ferraritobias/proteus/hardware/proteus-br/reports/contract-validation.txt

== 1. MCU (U1501) x PINOUT-CONTRACT ==
OK   U1501 BOOT0 (pad 138)        /mcu/BOOT0 (esperado substr:BOOT0)
OK   U1501 NRST (pad 25)          /mcu/nRESET (esperado substr:nRESET)
OK   U1501 PA0 (pad 34)           AV5_F (esperado AV5_F)
OK   U1501 PA1 (pad 35)           AV6_F (esperado AV6_F)
OK   U1501 PA11 (pad 103)         /mcu/USB_D- (esperado substr:USB_D-)
OK   U1501 PA12 (pad 104)         /mcu/USB_D+ (esperado substr:USB_D+)
OK   U1501 PA13 (pad 105)         /mcu/SWDIO (esperado substr:SWDIO)
OK   U1501 PA14 (pad 109)         /mcu/SWCLK (esperado substr:SWCLK)
OK   U1501 PA2 (pad 36)           AV7_F (esperado AV7_F)
OK   U1501 PA3 (pad 37)           AV8_F (esperado AV8_F)
OK   U1501 PA4 (pad 40)           AV9_F (esperado AV9_F)
OK   U1501 PA5 (pad 41)           AV10_F (esperado AV10_F)
OK   U1501 PA6 (pad 42)           AV11_F (esperado AV11_F)
OK   U1501 PA7 (pad 43)           /mcu/12V_DIVIDED (esperado substr:12V_DIVIDED)
OK   U1501 PA8 (pad 100)          HS2_IN (esperado HS2_IN)
OK   U1501 PA9 (pad 101)          HS1_IN (esperado HS1_IN)
OK   U1501 PB0 (pad 46)           AT3_F (esperado AT3_F)
OK   U1501 PB1 (pad 47)           AT4_F (esperado AT4_F)
OK   U1501 PB12 (pad 73)          CAN2_RX (esperado CAN2_RX)
OK   U1501 PB13 (pad 74)          CAN2_TX (esperado CAN2_TX)
OK   U1501 PB2 (pad 48)           GND (esperado GND)
OK   U1501 PB4 (pad 134)          LS8_IN (esperado LS8_IN)
OK   U1501 PB5 (pad 135)          LS9_IN (esperado LS9_IN)
OK   U1501 PB6 (pad 136)          LS10_IN (esperado LS10_IN)
OK   U1501 PB7 (pad 137)          LS11_IN (esperado LS11_IN)
OK   U1501 PB8 (pad 139)          LS12_IN (esperado LS12_IN)
OK   U1501 PB9 (pad 140)          LS13_IN (esperado LS13_IN)
OK   U1501 PC0 (pad 26)           AV1_F (esperado AV1_F)
OK   U1501 PC1 (pad 27)           AV2_F (esperado AV2_F)
OK   U1501 PC10 (pad 111)         /mcu/SD_SCK (esperado substr:SD_SCK)
OK   U1501 PC11 (pad 112)         /mcu/SD_MISO (esperado substr:SD_MISO)
OK   U1501 PC12 (pad 113)         /mcu/SD_MOSI (esperado substr:SD_MOSI)
OK   U1501 PC14 (pad 8)           5V_SENSOR_2_PG (esperado 5V_SENSOR_2_PG)
OK   U1501 PC15 (pad 9)           5V_SENSOR_1_PG (esperado 5V_SENSOR_1_PG)
OK   U1501 PC2 (pad 28)           AV3_F (esperado AV3_F)
OK   U1501 PC3 (pad 29)           AV4_F (esperado AV4_F)
OK   U1501 PC4 (pad 44)           AT1_F (esperado AT1_F)
OK   U1501 PC5 (pad 45)           AT2_F (esperado AT2_F)
OK   U1501 PC6 (pad 96)           HALL_OUT_1 (esperado HALL_OUT_1)
OK   U1501 PC7 (pad 97)           IGN5_IN (esperado IGN5_IN)
OK   U1501 PC8 (pad 98)           IGN4_IN (esperado IGN4_IN)
OK   U1501 PC9 (pad 99)           IGN3_IN (esperado IGN3_IN)
OK   U1501 PD0 (pad 114)          CAN1_RX (esperado CAN1_RX)
OK   U1501 PD1 (pad 115)          CAN1_TX (esperado CAN1_TX)
OK   U1501 PD10 (pad 79)          ETB1_DIR (esperado ETB1_DIR)
OK   U1501 PD11 (pad 80)          ETB1_DIS (esperado ETB1_DIS)
OK   U1501 PD12 (pad 81)          ETB1_PWM (esperado ETB1_PWM)
OK   U1501 PD13 (pad 82)          ETB2_PWM (esperado ETB2_PWM)
OK   U1501 PD14 (pad 85)          HS4_IN (esperado HS4_IN)
OK   U1501 PD15 (pad 86)          HS3_IN (esperado HS3_IN)
OK   U1501 PD2 (pad 116)          /mcu/SD_CS (esperado substr:SD_CS)
OK   U1501 PD3 (pad 117)          IGN2_IN (esperado IGN2_IN)
OK   U1501 PD4 (pad 118)          IGN1_IN (esperado IGN1_IN)
OK   U1501 PD5 (pad 119)          UART_TX (esperado UART_TX)
OK   U1501 PD6 (pad 122)          UART_RX (esperado UART_RX)
OK   U1501 PD7 (pad 123)          LS1_IN (esperado LS1_IN)
OK   U1501 PD8 (pad 77)           ETB2_DIS (esperado ETB2_DIS)
OK   U1501 PD9 (pad 78)           ETB2_DIR (esperado ETB2_DIR)
OK   U1501 PE0 (pad 141)          LS14_IN (esperado LS14_IN)
OK   U1501 PE1 (pad 142)          LS15_IN (esperado LS15_IN)
OK   U1501 PE11 (pad 64)          HALL_OUT_2 (esperado HALL_OUT_2)
OK   U1501 PE12 (pad 65)          HALL_OUT_3 (esperado HALL_OUT_3)
OK   U1501 PE13 (pad 66)          HALL_OUT_5 (esperado HALL_OUT_5)
OK   U1501 PE14 (pad 67)          HALL_OUT_4 (esperado HALL_OUT_4)
OK   U1501 PE15 (pad 68)          HALL_OUT_6 (esperado HALL_OUT_6)
OK   U1501 PE2 (pad 1)            LS16_IN (esperado LS16_IN)
OK   U1501 PE5 (pad 4)            /mcu/LED3 (esperado substr:LED3)
OK   U1501 PE7 (pad 58)           VR1_OUT (esperado VR1_OUT)
OK   U1501 PE8 (pad 59)           VR2_OUT (esperado VR2_OUT)
OK   U1501 PF4 (pad 14)           KNOCK1_F (esperado KNOCK1_F)
OK   U1501 PF5 (pad 15)           KNOCK2_F (esperado KNOCK2_F)
OK   U1501 PF7 (pad 19)           AUX_SPI_SCK (esperado AUX_SPI_SCK)
OK   U1501 PF8 (pad 20)           AUX_SPI_MISO (esperado AUX_SPI_MISO)
OK   U1501 PF9 (pad 21)           AUX_SPI_MOSI (esperado AUX_SPI_MOSI)
OK   U1501 PG0 (pad 56)           EXP_GPIO0 (esperado EXP_GPIO0)
OK   U1501 PG10 (pad 125)         LS3_IN (esperado LS3_IN)
OK   U1501 PG11 (pad 126)         LS4_IN (esperado LS4_IN)
OK   U1501 PG12 (pad 127)         LS5_IN (esperado LS5_IN)
OK   U1501 PG13 (pad 128)         LS6_IN (esperado LS6_IN)
OK   U1501 PG14 (pad 129)         LS7_IN (esperado LS7_IN)
OK   U1501 PG15 (pad 132)         AUX_SPI_CS (esperado AUX_SPI_CS)
OK   U1501 PG2 (pad 87)           IGN12_IN (esperado IGN12_IN)
OK   U1501 PG3 (pad 88)           IGN11_IN (esperado IGN11_IN)
OK   U1501 PG4 (pad 89)           IGN10_IN (esperado IGN10_IN)
OK   U1501 PG5 (pad 90)           IGN9_IN (esperado IGN9_IN)
OK   U1501 PG6 (pad 91)           IGN8_IN (esperado IGN8_IN)
OK   U1501 PG7 (pad 92)           IGN7_IN (esperado IGN7_IN)
OK   U1501 PG8 (pad 93)           IGN6_IN (esperado IGN6_IN)
OK   U1501 PG9 (pad 124)          LS2_IN (esperado LS2_IN)
OK   U1501 PH0 (pad 23)           Net-(U1501-PH0) (esperado substr:PH0)
OK   U1501 PH1 (pad 24)           Net-(U1501-PH1) (esperado substr:PH1)
OK   U1501 PE3 livre/NC           unconnected-(U1501-PE3-Pad2)
OK   U1501 PE4 livre/NC           unconnected-(U1501-PE4-Pad3)
OK   U1501 PE6 livre/NC           unconnected-(U1501-PE6-Pad5)
OK   U1501 PB10 livre/NC          unconnected-(U1501-PB10-Pad69)
OK   U1501 PB11 livre/NC          unconnected-(U1501-PB11-Pad70)
OK   U1501 PF6 livre/NC           unconnected-(U1501-PF6-Pad18)
OK   U1501 PA10 livre/NC          unconnected-(U1501-PA10-Pad102)
OK   U1501 PA15 livre/NC          unconnected-(U1501-PA15-Pad110)
OK   U1501 PB3 livre/NC           unconnected-(U1501-PB3-Pad133)
OK   U1501 PB14 livre/NC          unconnected-(U1501-PB14-Pad75)
OK   U1501 PB15 livre/NC          unconnected-(U1501-PB15-Pad76)
OK   U1501 PC13 livre/NC          unconnected-(U1501-PC13-Pad7)
OK   U1501 PE9 livre/NC           unconnected-(U1501-PE9-Pad60)
OK   U1501 PE10 livre/NC          unconnected-(U1501-PE10-Pad63)
OK   U1501 PF0 livre/NC           unconnected-(U1501-PF0-Pad10)
OK   U1501 PF1 livre/NC           unconnected-(U1501-PF1-Pad11)
OK   U1501 PF2 livre/NC           unconnected-(U1501-PF2-Pad12)
OK   U1501 PF3 livre/NC           unconnected-(U1501-PF3-Pad13)
OK   U1501 PF10 livre/NC          unconnected-(U1501-PF10-Pad22)
OK   U1501 PF11 livre/NC          unconnected-(U1501-PF11-Pad49)
OK   U1501 PF12 livre/NC          unconnected-(U1501-PF12-Pad50)
OK   U1501 PF13 livre/NC          unconnected-(U1501-PF13-Pad53)
OK   U1501 PF14 livre/NC          unconnected-(U1501-PF14-Pad54)
OK   U1501 PF15 livre/NC          unconnected-(U1501-PF15-Pad55)
OK   U1501 PG1 livre/NC           unconnected-(U1501-PG1-Pad57)

== 2. Conectores x alocacao (YAML) ==
OK   J101.1                       12V_RAW (esperado 12V_RAW)
OK   J101.2                       12V_RAW (esperado 12V_RAW)
OK   J101.3                       GND (esperado GND)
OK   J101.4                       LS1 (esperado LS1)
OK   J101.5                       LS2 (esperado LS2)
OK   J101.6                       LS3 (esperado LS3)
OK   J101.7                       LS4 (esperado LS4)
OK   J101.8                       LS5 (esperado LS5)
OK   J101.9                       LS6 (esperado LS6)
OK   J101.10                      LS7 (esperado LS7)
OK   J101.11                      LS8 (esperado LS8)
OK   J101.12                      HS1 (esperado HS1)
OK   J101.13                      HS2 (esperado HS2)
OK   J101.14                      GND (esperado GND)
OK   J101.15                      GND (esperado GND)
OK   J101.16                      GND (esperado GND)
OK   J101.17                      LS9 (esperado LS9)
OK   J101.18                      LS10 (esperado LS10)
OK   J101.19                      LS11 (esperado LS11)
OK   J101.20                      LS12 (esperado LS12)
OK   J101.21                      LS13 (esperado LS13)
OK   J101.22                      LS14 (esperado LS14)
OK   J101.23                      LS15 (esperado LS15)
OK   J101.24                      LS16 (esperado LS16)
OK   J101.25                      HS3 (esperado HS3)
OK   J101.26                      HS4 (esperado HS4)
OK   J102.1                       GND (esperado GND)
OK   J102.2                       IGN1 (esperado IGN1)
OK   J102.3                       IGN2 (esperado IGN2)
OK   J102.4                       IGN3 (esperado IGN3)
OK   J102.5                       IGN4 (esperado IGN4)
OK   J102.6                       IGN5 (esperado IGN5)
OK   J102.7                       IGN6 (esperado IGN6)
OK   J102.8                       GND (esperado GND)
OK   J102.9                       ETB1+ (esperado ETB1+)
OK   J102.10                      ETB1- (esperado ETB1-)
OK   J102.11 reservado            unconnected-(J102-P11-Pad11)
OK   J102.12 reservado            unconnected-(J102-P12-Pad12)
OK   J102.13                      GND (esperado GND)
OK   J102.14                      GND (esperado GND)
OK   J102.15                      IGN7 (esperado IGN7)
OK   J102.16                      IGN8 (esperado IGN8)
OK   J102.17                      IGN9 (esperado IGN9)
OK   J102.18                      IGN10 (esperado IGN10)
OK   J102.19                      IGN11 (esperado IGN11)
OK   J102.20                      IGN12 (esperado IGN12)
OK   J102.21                      GND (esperado GND)
OK   J102.22                      ETB2+ (esperado ETB2+)
OK   J102.23                      ETB2- (esperado ETB2-)
OK   J102.24 reservado            unconnected-(J102-P24-Pad24)
OK   J102.25 reservado            unconnected-(J102-P25-Pad25)
OK   J102.26                      GND (esperado GND)
OK   J103.1                       5V_SENSOR_1 (esperado 5V_SENSOR_1)
OK   J103.2                       GND (esperado GND)
OK   J103.3                       AV1 (esperado AV1)
OK   J103.4                       AV2 (esperado AV2)
OK   J103.5                       AV3 (esperado AV3)
OK   J103.6                       AV4 (esperado AV4)
OK   J103.7                       AV5 (esperado AV5)
OK   J103.8                       AV6 (esperado AV6)
OK   J103.9                       GND (esperado GND)
OK   J103.10                      AT1 (esperado AT1)
OK   J103.11                      AT2 (esperado AT2)
OK   J103.12                      KNOCK_1 (esperado KNOCK_1)
OK   J103.13                      GND (esperado GND)
OK   J103.14                      5V_SENSOR_2 (esperado 5V_SENSOR_2)
OK   J103.15                      GND (esperado GND)
OK   J103.16                      AV7 (esperado AV7)
OK   J103.17                      AV8 (esperado AV8)
OK   J103.18                      AV9 (esperado AV9)
OK   J103.19                      AV10 (esperado AV10)
OK   J103.20                      AV11 (esperado AV11)
OK   J103.21                      GND (esperado GND)
OK   J103.22                      AT3 (esperado AT3)
OK   J103.23                      AT4 (esperado AT4)
OK   J103.24                      KNOCK_2 (esperado KNOCK_2)
OK   J103.25                      GND (esperado GND)
OK   J103.26 reservado            unconnected-(J103-P26-Pad26)
OK   J104.1                       5V_SENSOR_1 (esperado 5V_SENSOR_1)
OK   J104.2                       GND (esperado GND)
OK   J104.3                       DIGITAL_1 (esperado DIGITAL_1)
OK   J104.4                       DIGITAL_2 (esperado DIGITAL_2)
OK   J104.5                       DIGITAL_3 (esperado DIGITAL_3)
OK   J104.6                       DIGITAL_4 (esperado DIGITAL_4)
OK   J104.7                       GND (esperado GND)
OK   J104.8                       VR1+ (esperado VR1+)
OK   J104.9                       VR1- (esperado VR1-)
OK   J104.10                      GND (esperado GND)
OK   J104.11                      CAN1_H (esperado CAN1_H)
OK   J104.12                      CAN1_L (esperado CAN1_L)
OK   J104.13 reservado            unconnected-(J104-P13-Pad13)
OK   J104.14                      5V_SENSOR_1 (esperado 5V_SENSOR_1)
OK   J104.15                      GND (esperado GND)
OK   J104.16                      DIGITAL_5 (esperado DIGITAL_5)
OK   J104.17                      DIGITAL_6 (esperado DIGITAL_6)
OK   J104.18                      GND (esperado GND)
OK   J104.19 reservado            unconnected-(J104-P19-Pad19)
OK   J104.20                      VR2+ (esperado VR2+)
OK   J104.21                      VR2- (esperado VR2-)
OK   J104.22                      GND (esperado GND)
OK   J104.23                      CAN2_H (esperado CAN2_H)
OK   J104.24                      CAN2_L (esperado CAN2_L)
OK   J104.25 reservado            unconnected-(J104-P25-Pad25)
OK   J104.26 reservado            unconnected-(J104-P26-Pad26)
OK   J110.1                       12v_PROT (esperado 12v_PROT)
OK   J110.2                       12v_PROT (esperado 12v_PROT)
OK   J110.3                       GND (esperado GND)
OK   J110.4                       GND (esperado GND)
OK   J110.5                       +5V (esperado +5V)
OK   J110.6                       +5V (esperado +5V)
OK   J110.7                       CAN2_H (esperado CAN2_H)
OK   J110.8                       CAN2_L (esperado CAN2_L)
OK   J110.9                       GND (esperado GND)
OK   J110.10                      UART_TX (esperado UART_TX)
OK   J110.11                      UART_RX (esperado UART_RX)
OK   J110.12                      GND (esperado GND)
OK   J110.13                      AUX_SPI_SCK (esperado AUX_SPI_SCK)
OK   J110.14                      AUX_SPI_MISO (esperado AUX_SPI_MISO)
OK   J110.15                      AUX_SPI_MOSI (esperado AUX_SPI_MOSI)
OK   J110.16                      AUX_SPI_CS (esperado AUX_SPI_CS)
OK   J110.17                      +3V3 (esperado +3V3)
OK   J110.18                      GND (esperado GND)
OK   J110.19                      GND (esperado GND)
OK   J110.20                      EXP_GPIO0 (esperado EXP_GPIO0)

== Resultado ==
240 checagens, 0 divergencias
