ferraritobias/proteus/hardware/proteus-br/proteus-br-schematic.pdf

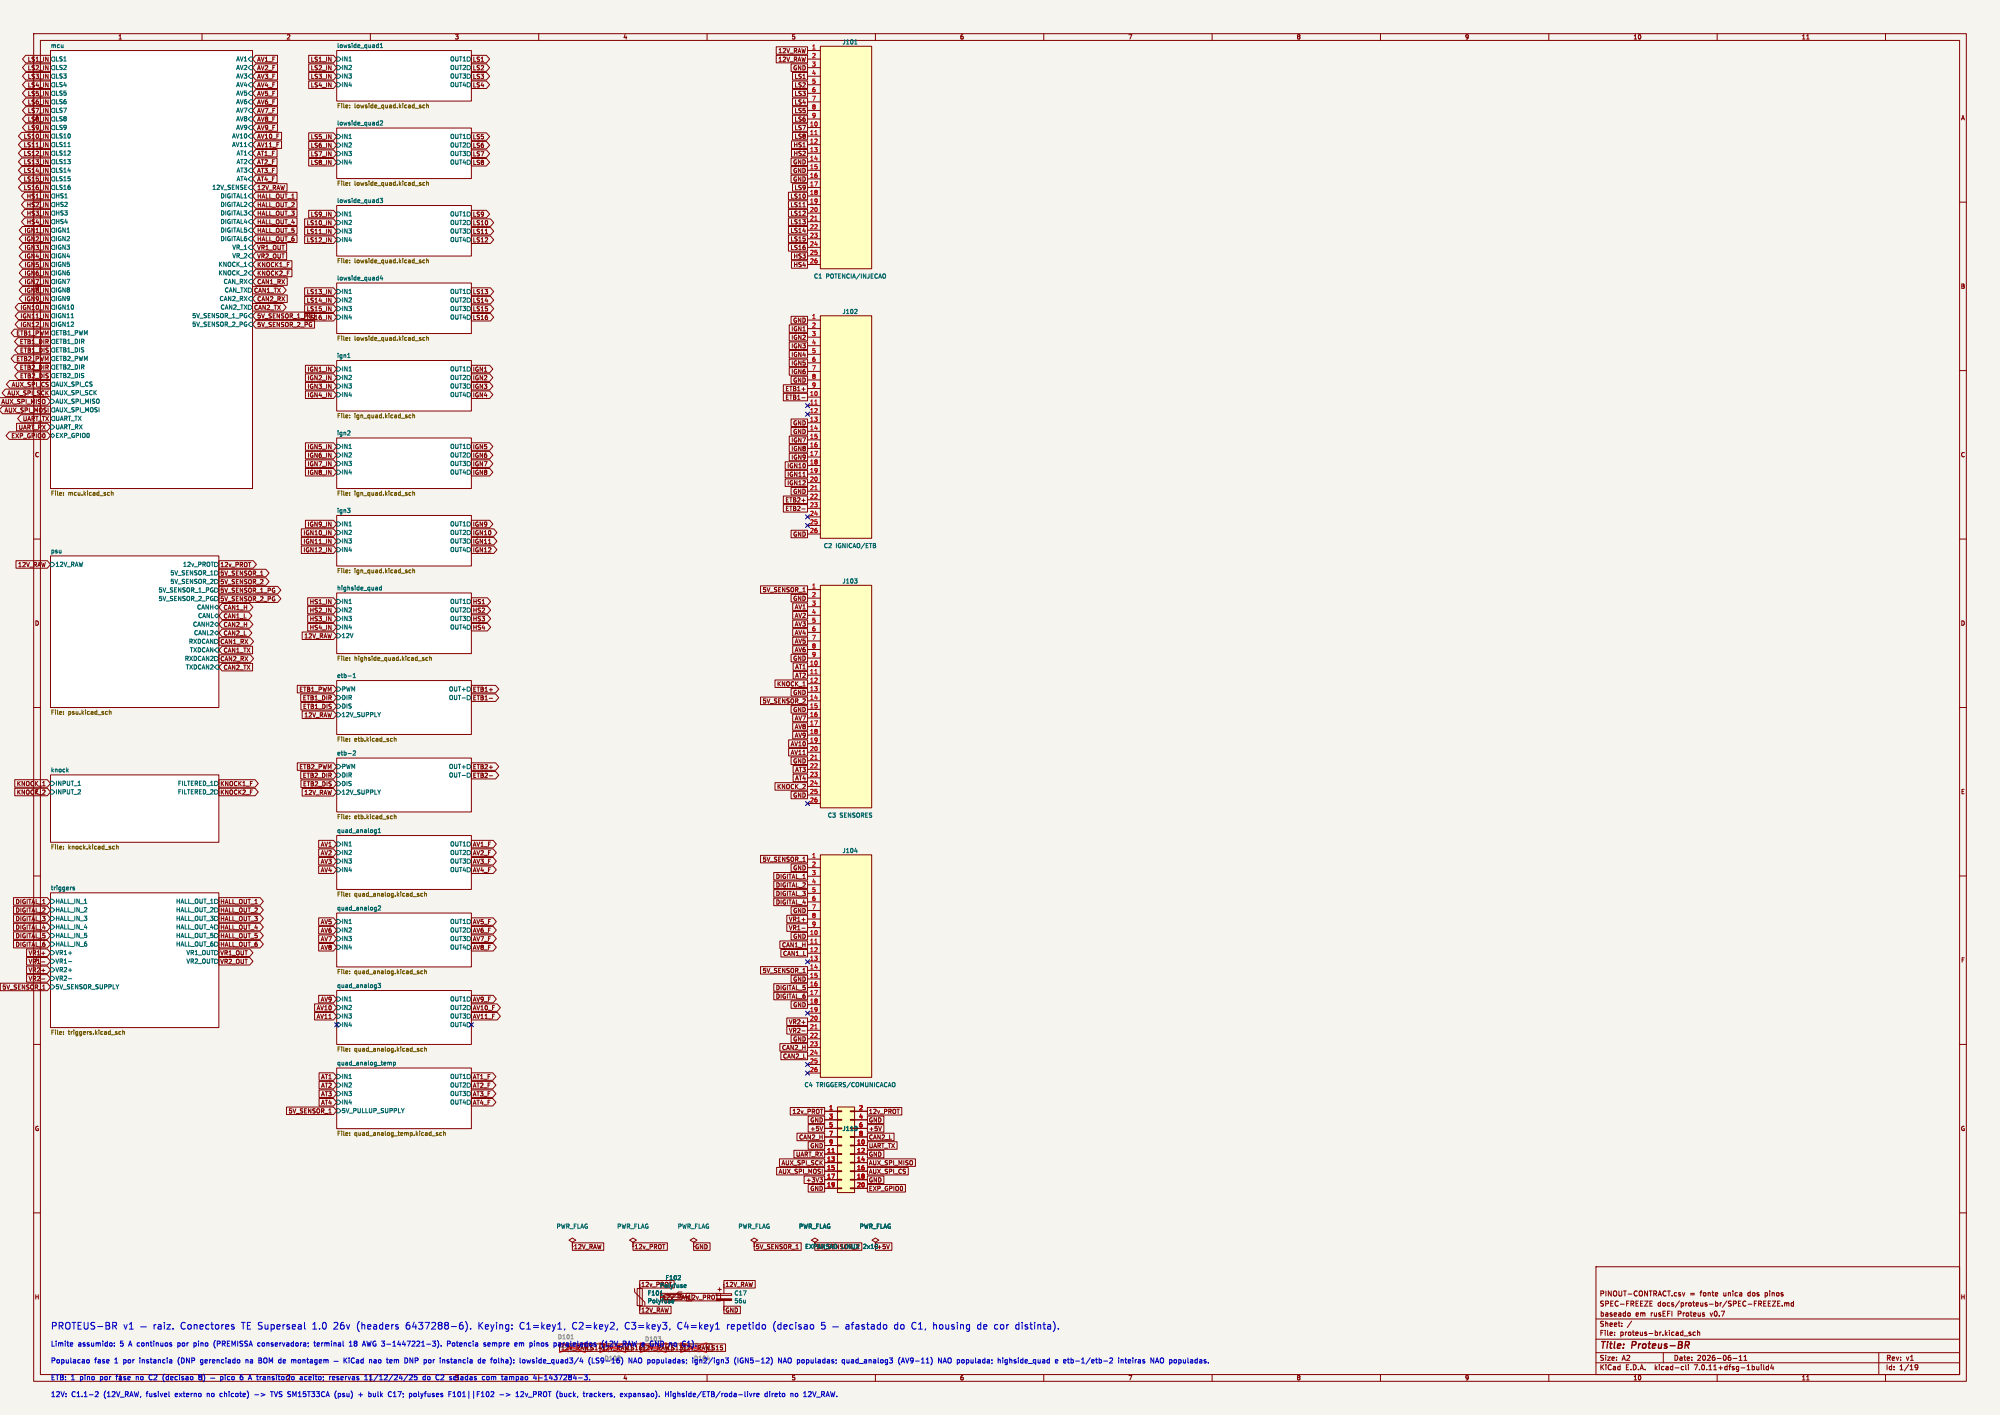
[picture p1: page 1]

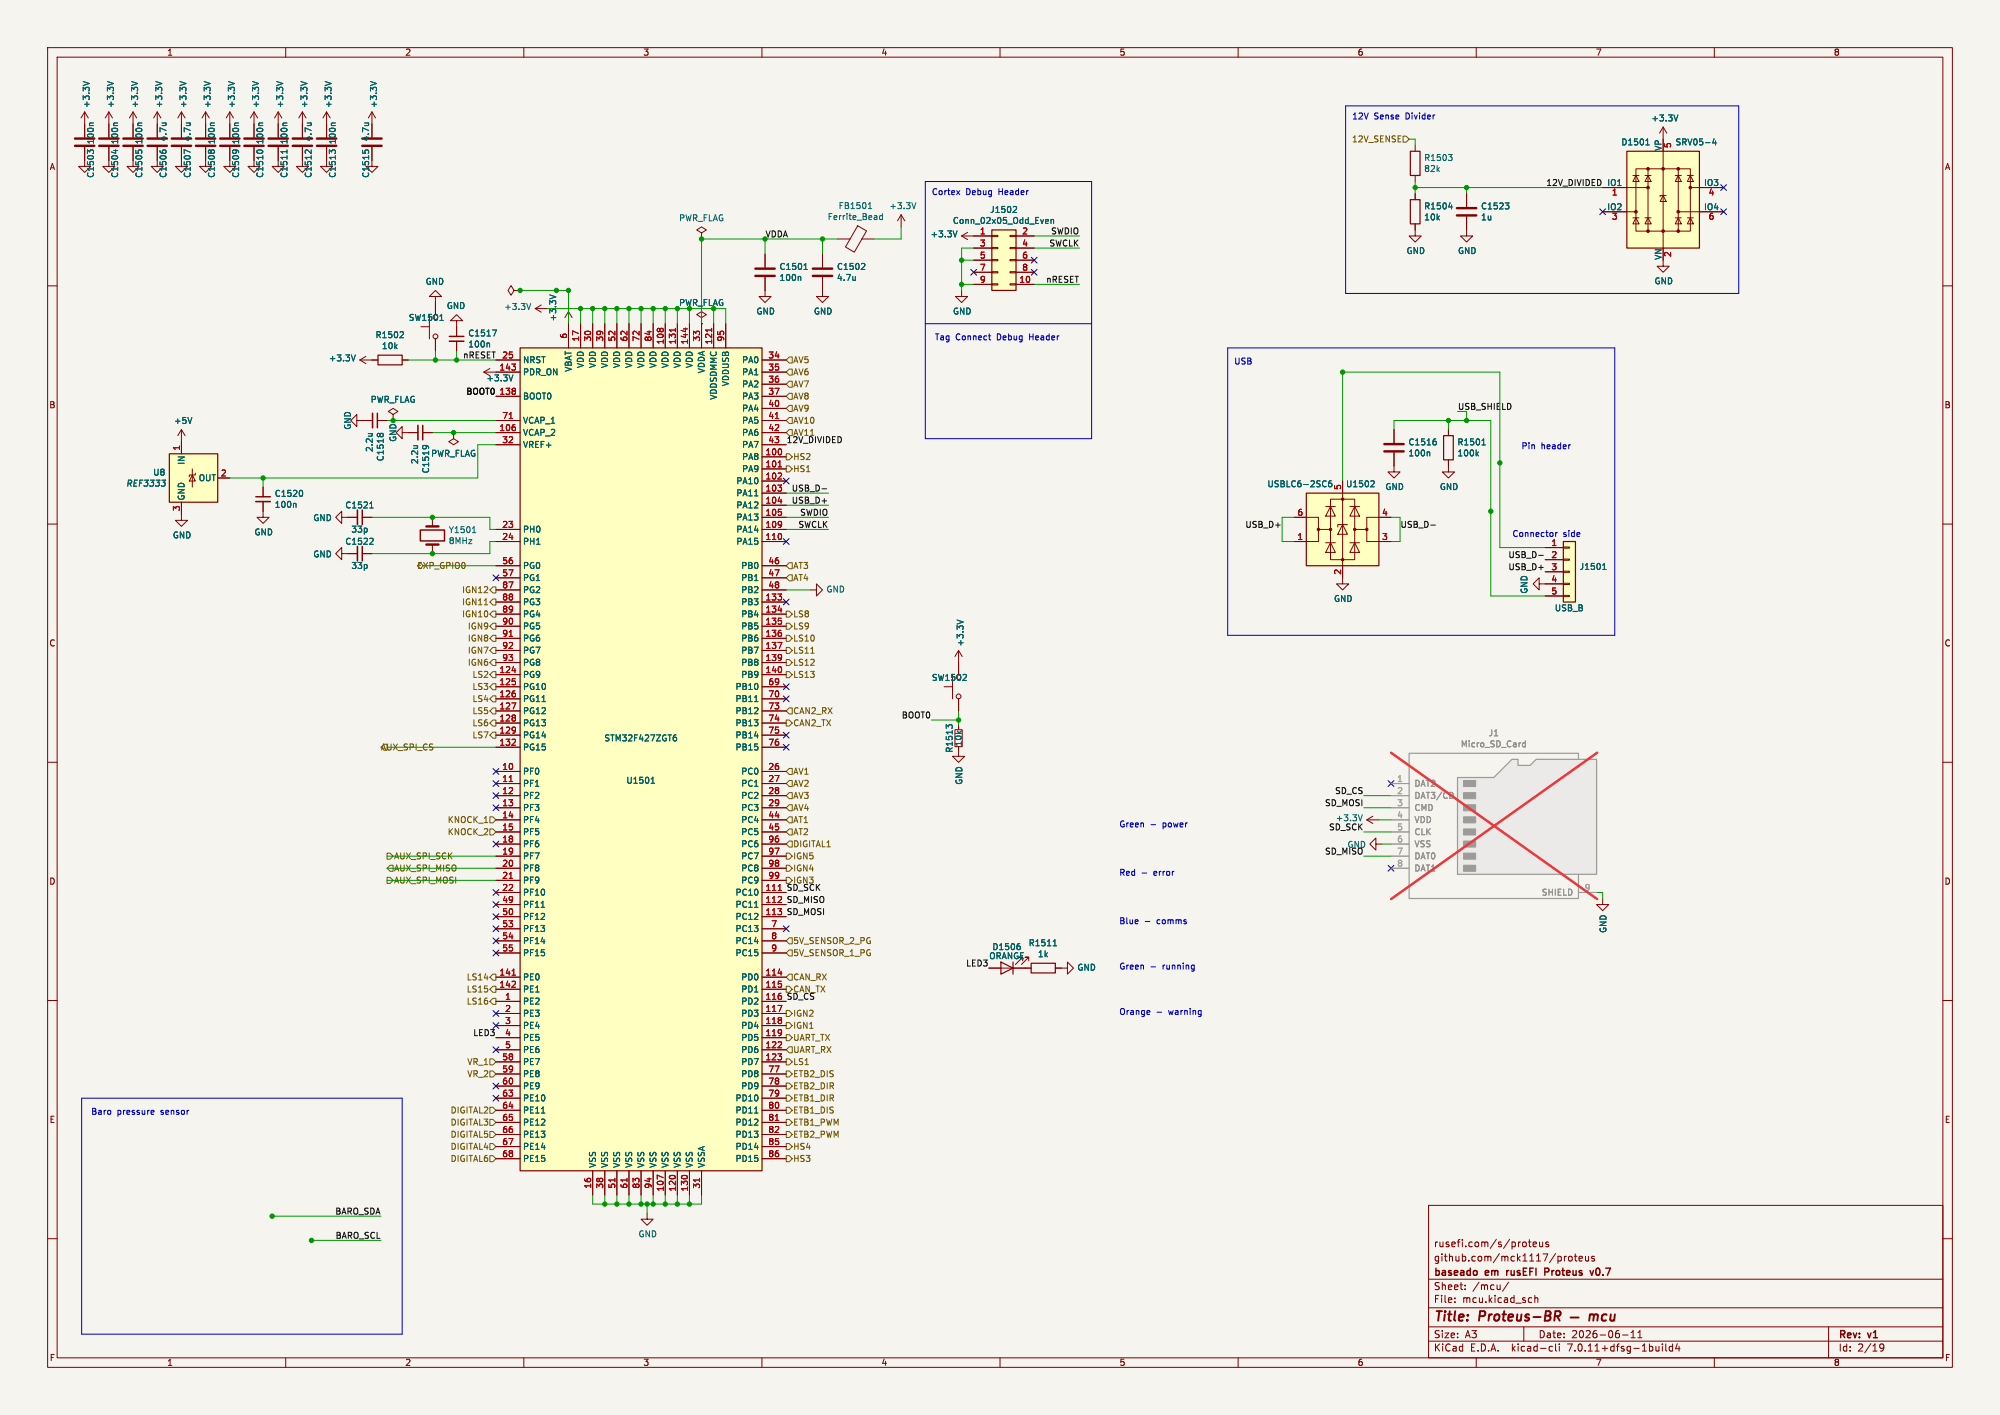
[picture p2: page 2]

SD_MOSI SD_CS
Orange - warning Blue - comms Green - power

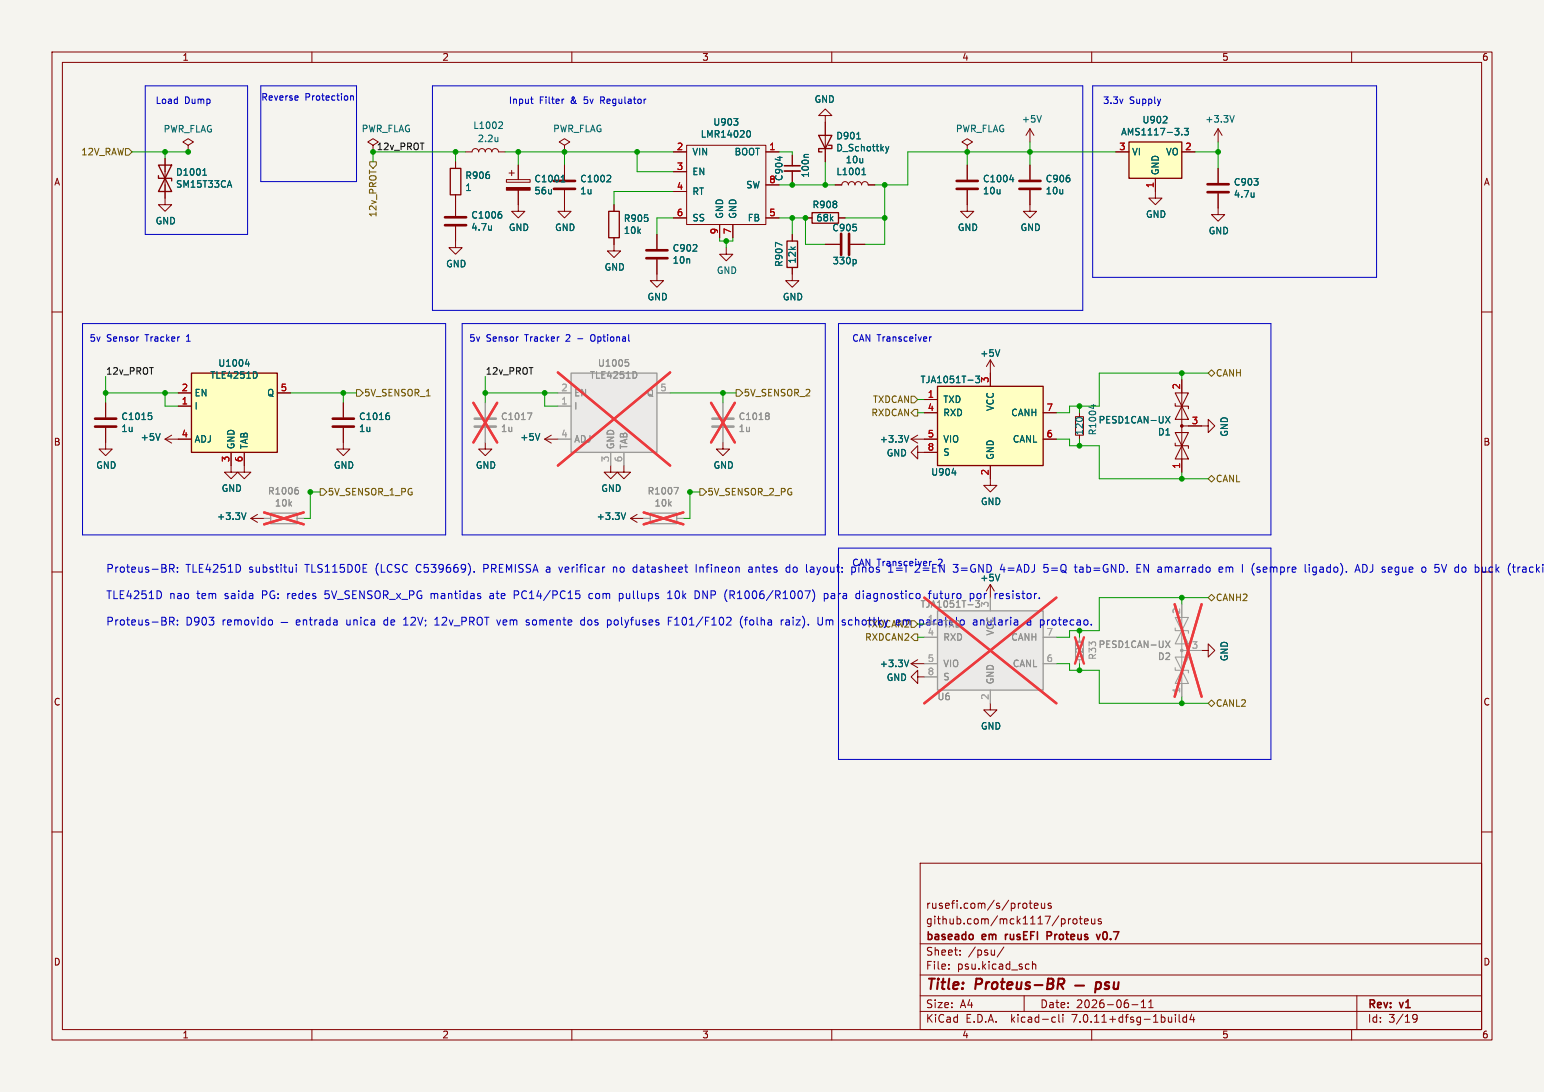
[picture p3: page 3]

1 VO 2 VI 3 GND GND

3 RXD 4 VIO 5 CANL 6 CANH 7 S

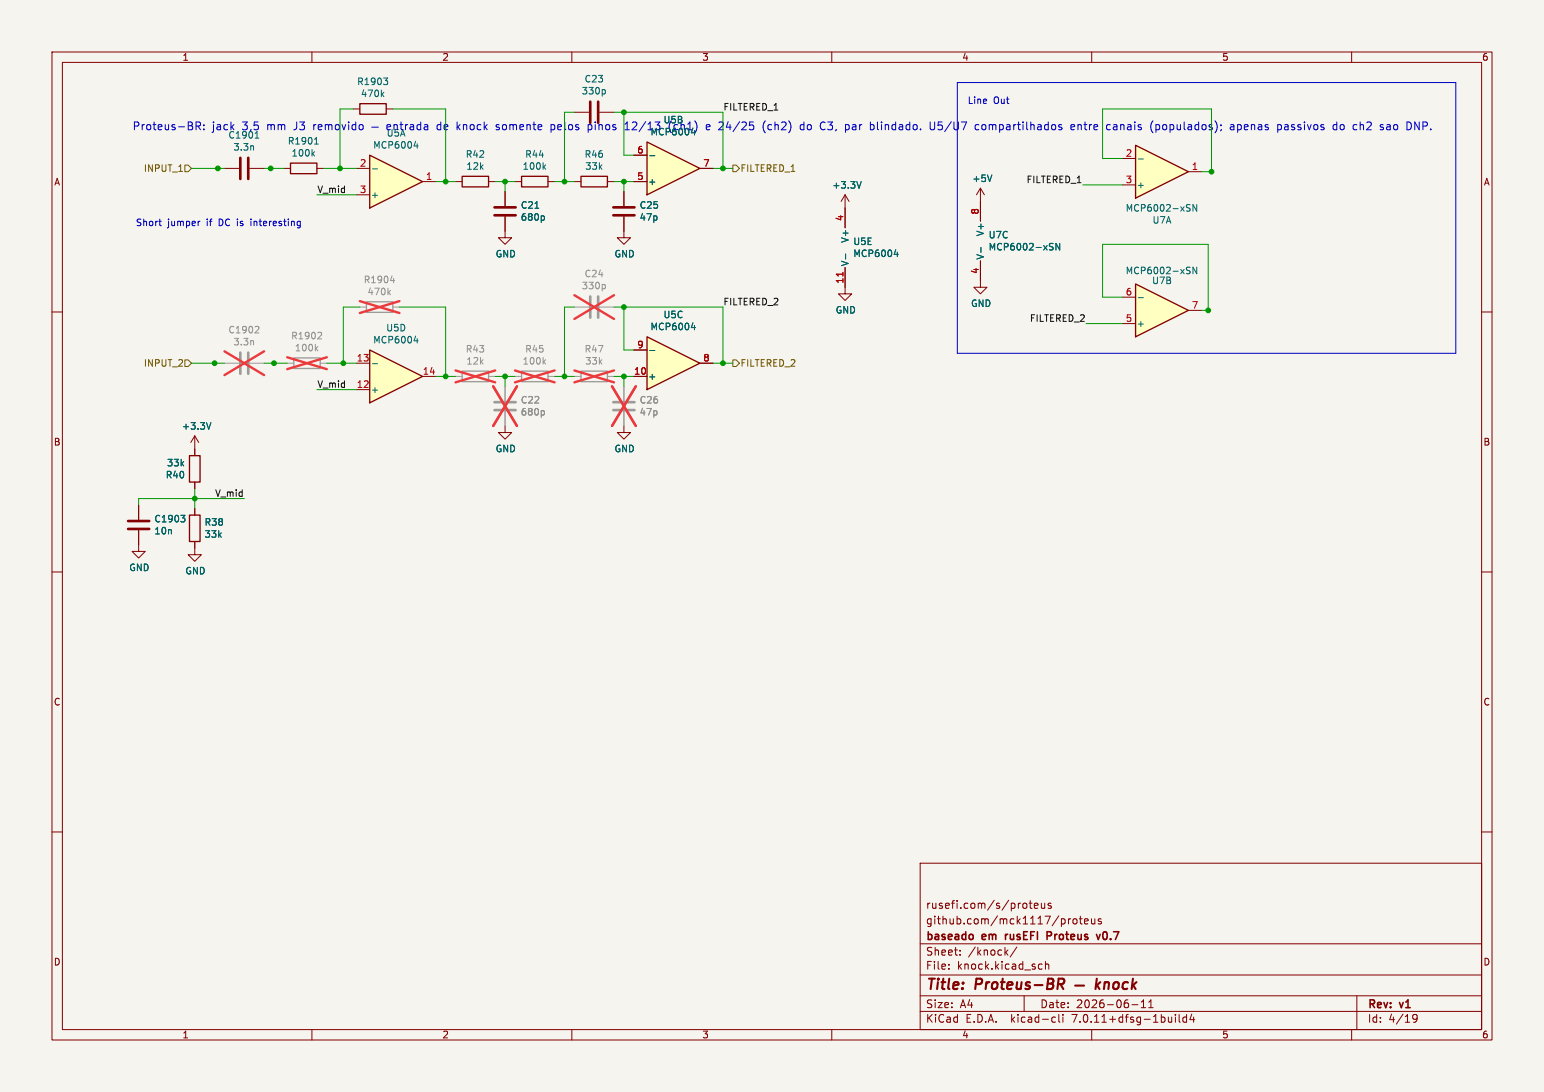
[picture p4: page 4]

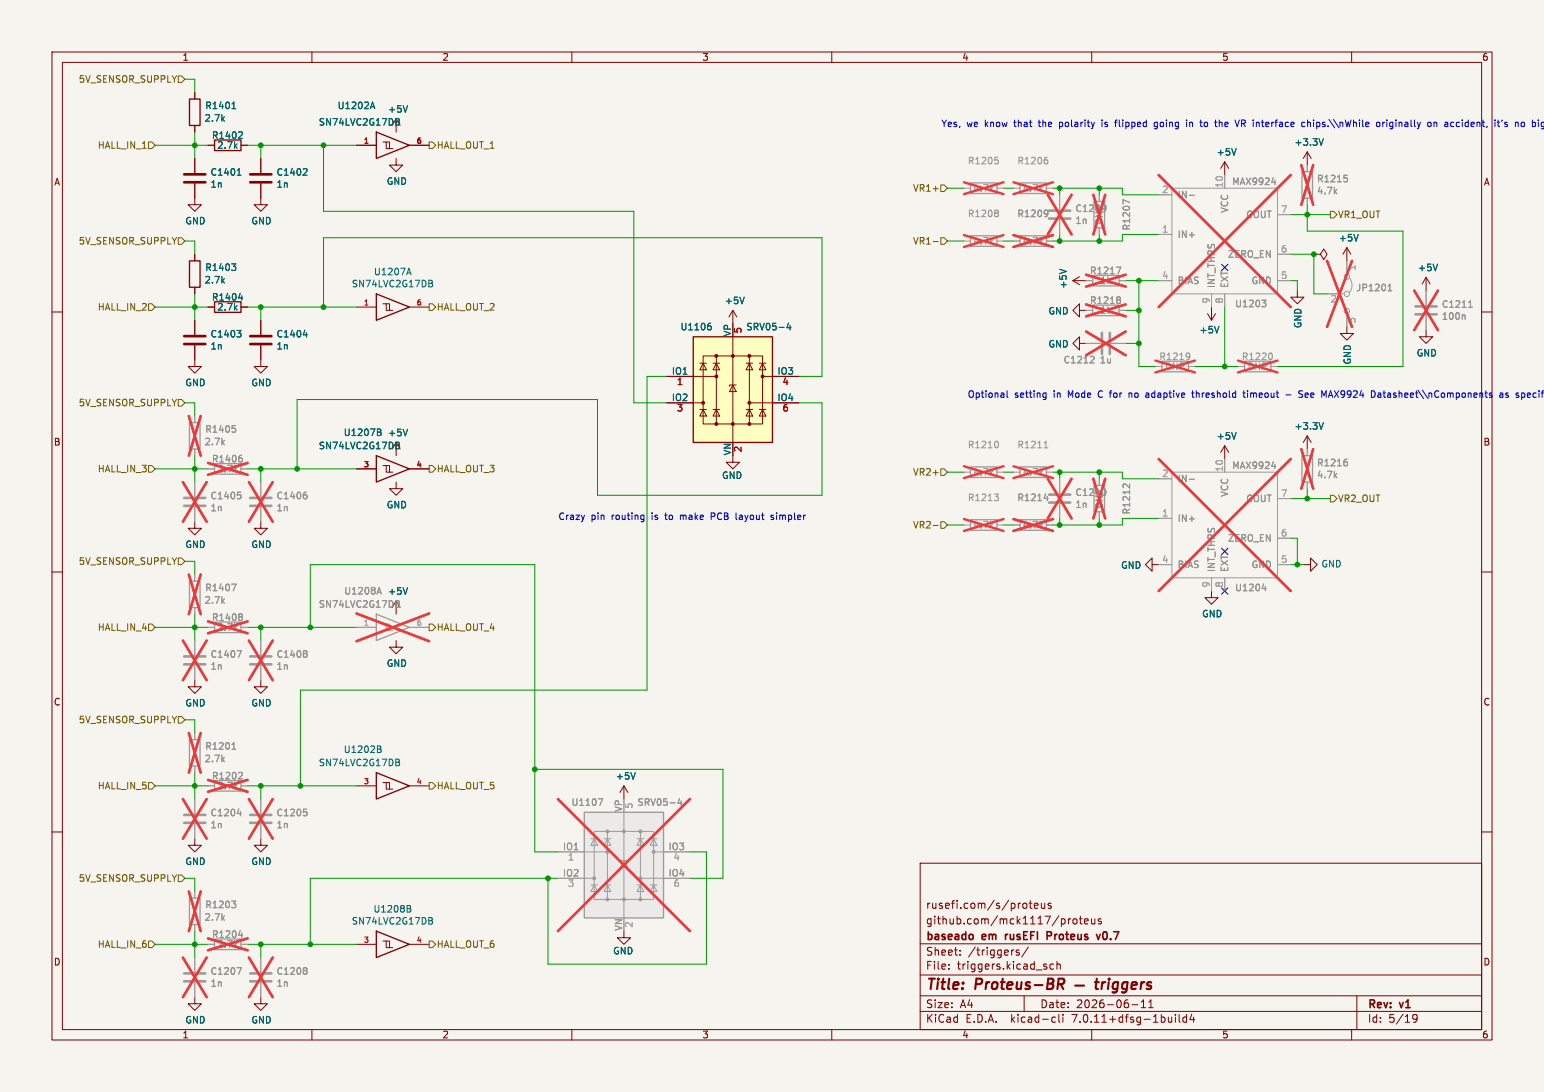
[picture p5: page 5]

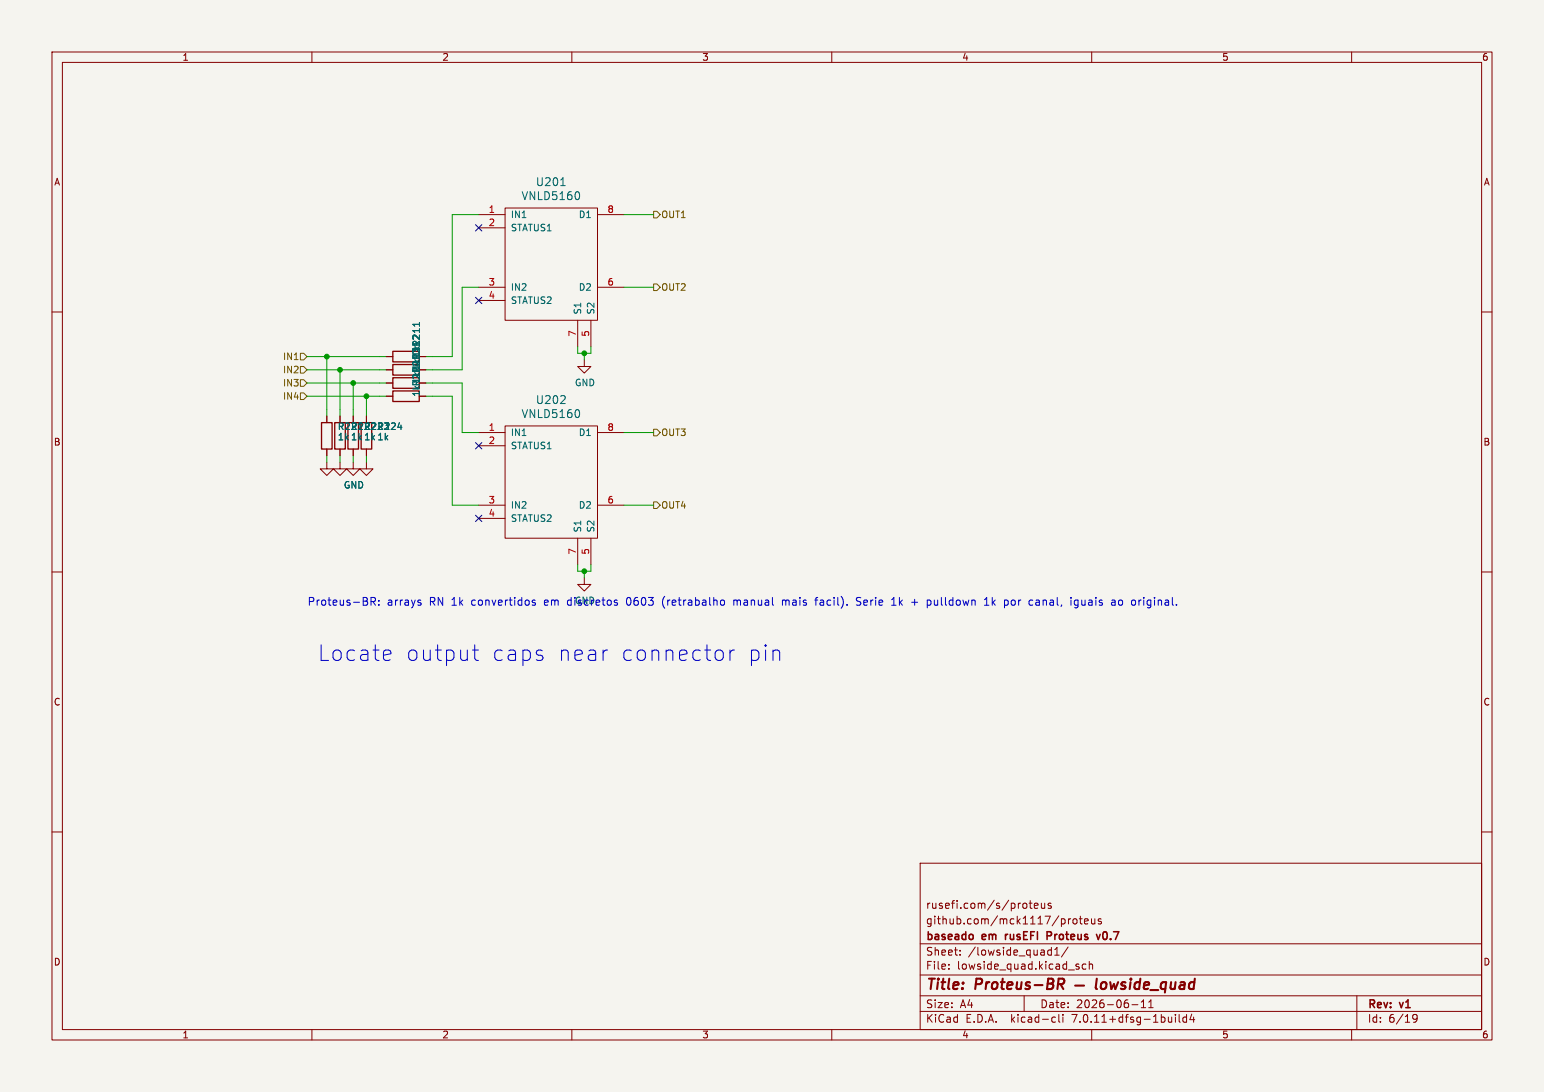
[picture p6: page 6]

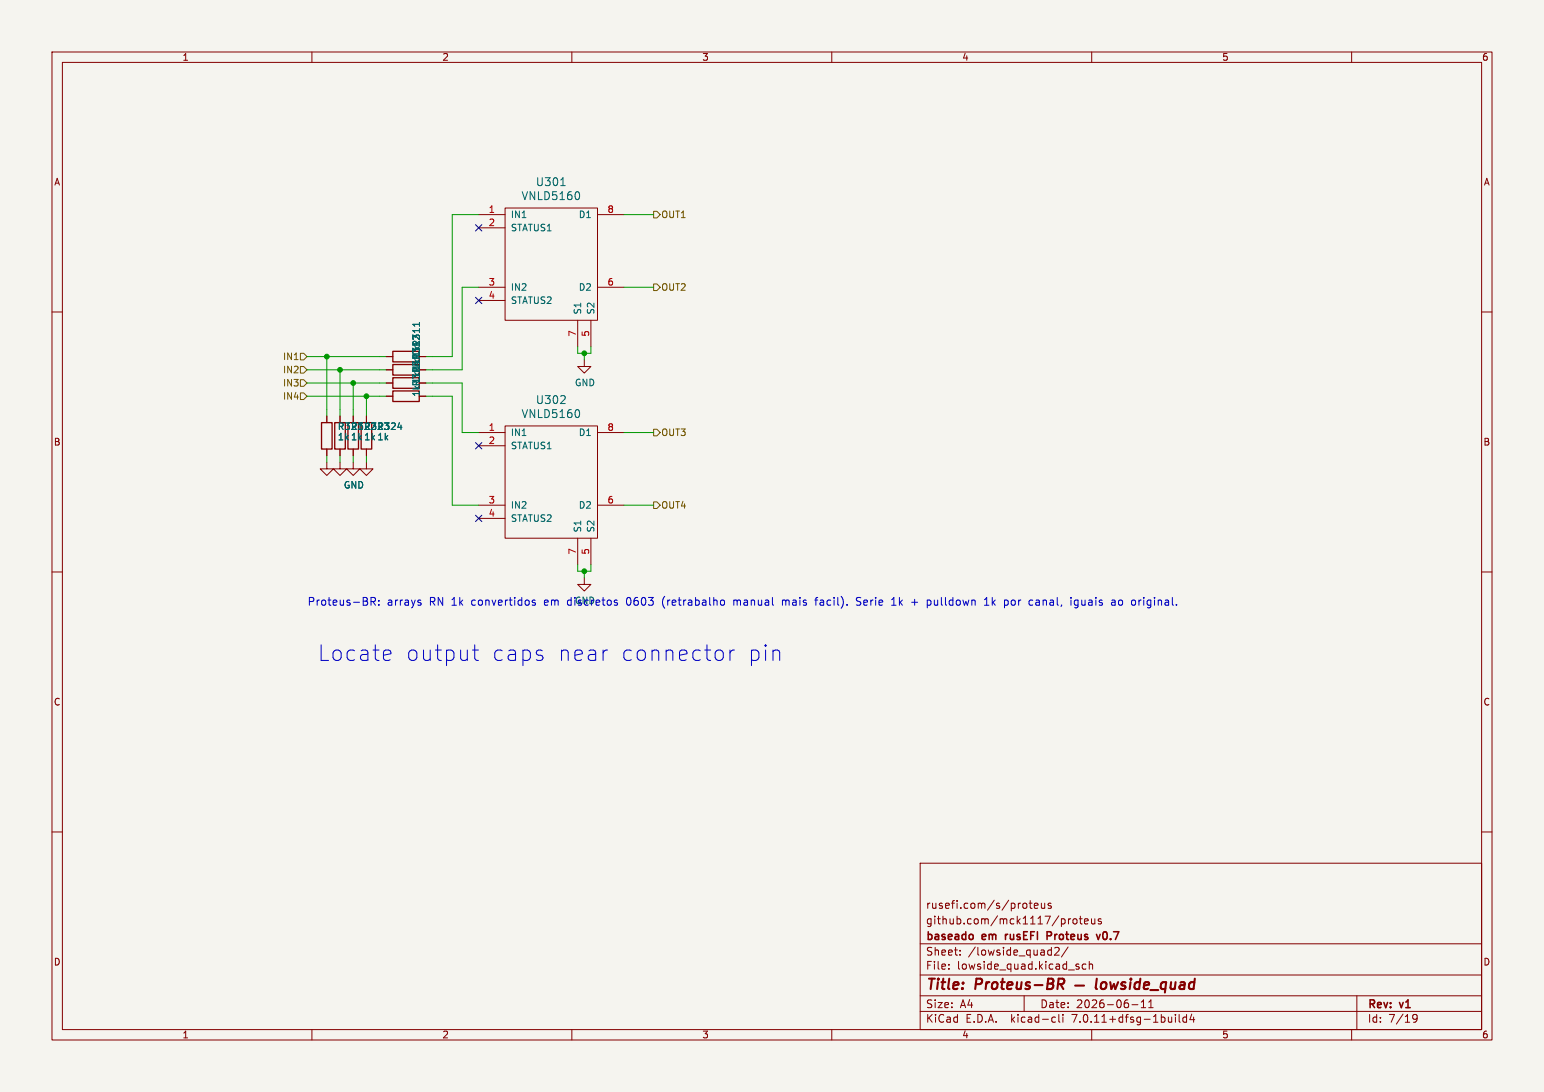
[picture p7: page 7]

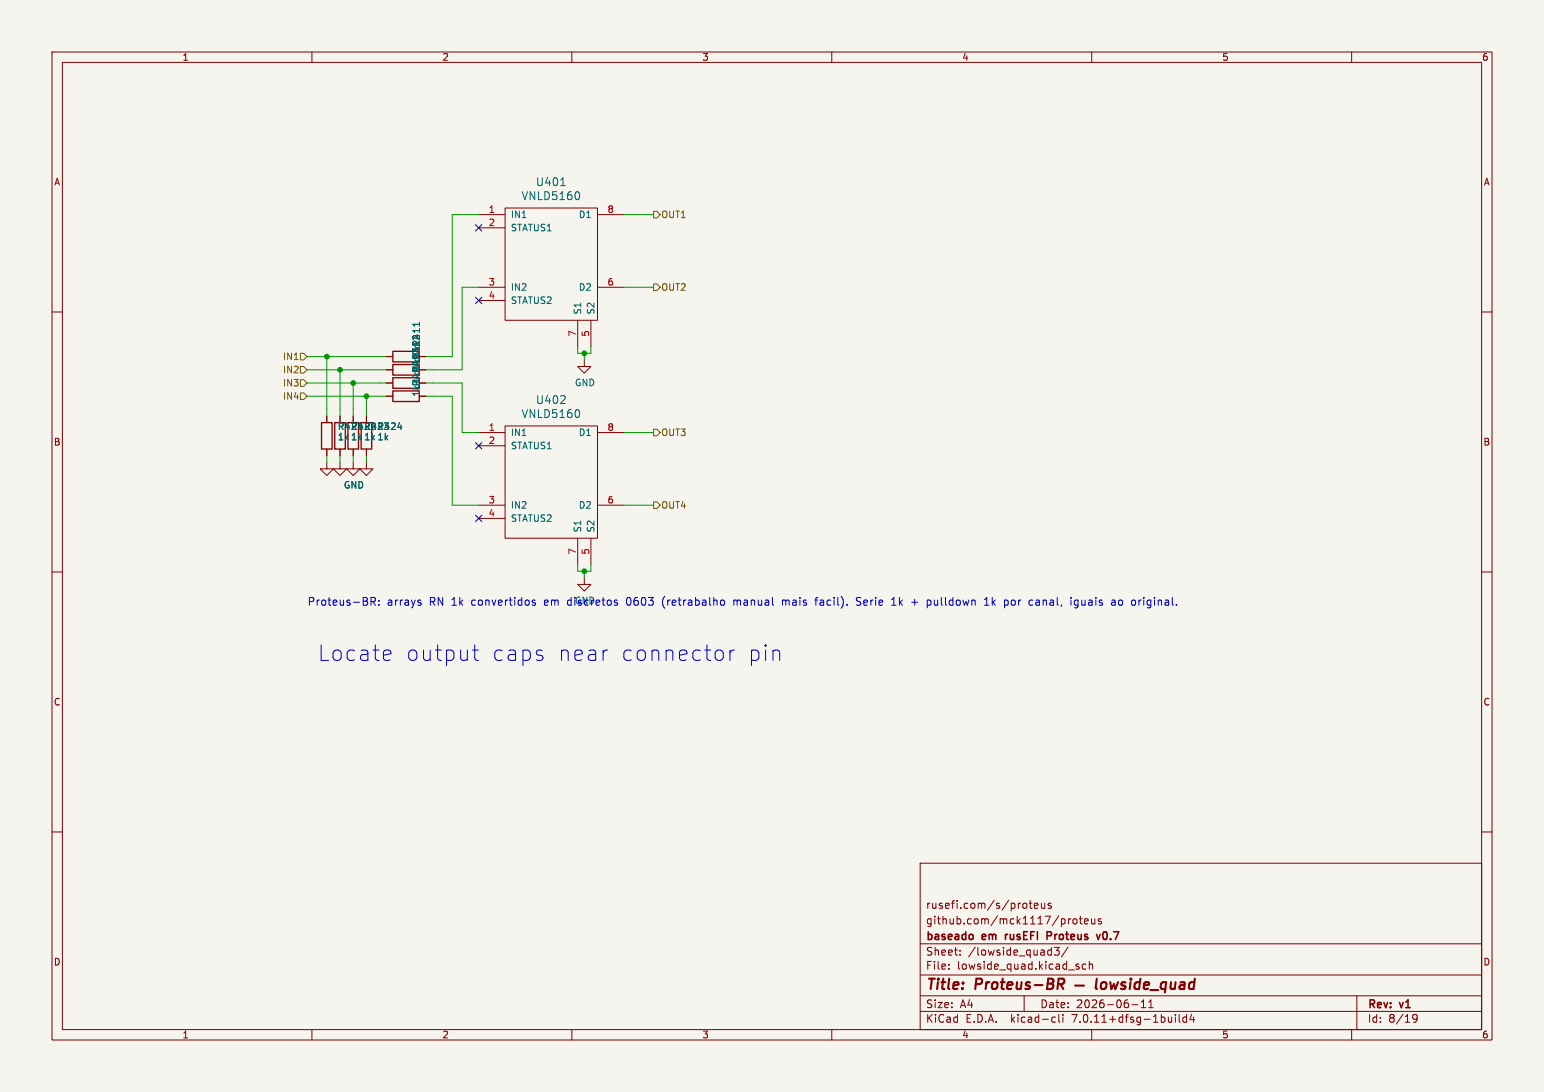
[picture p8: page 8]

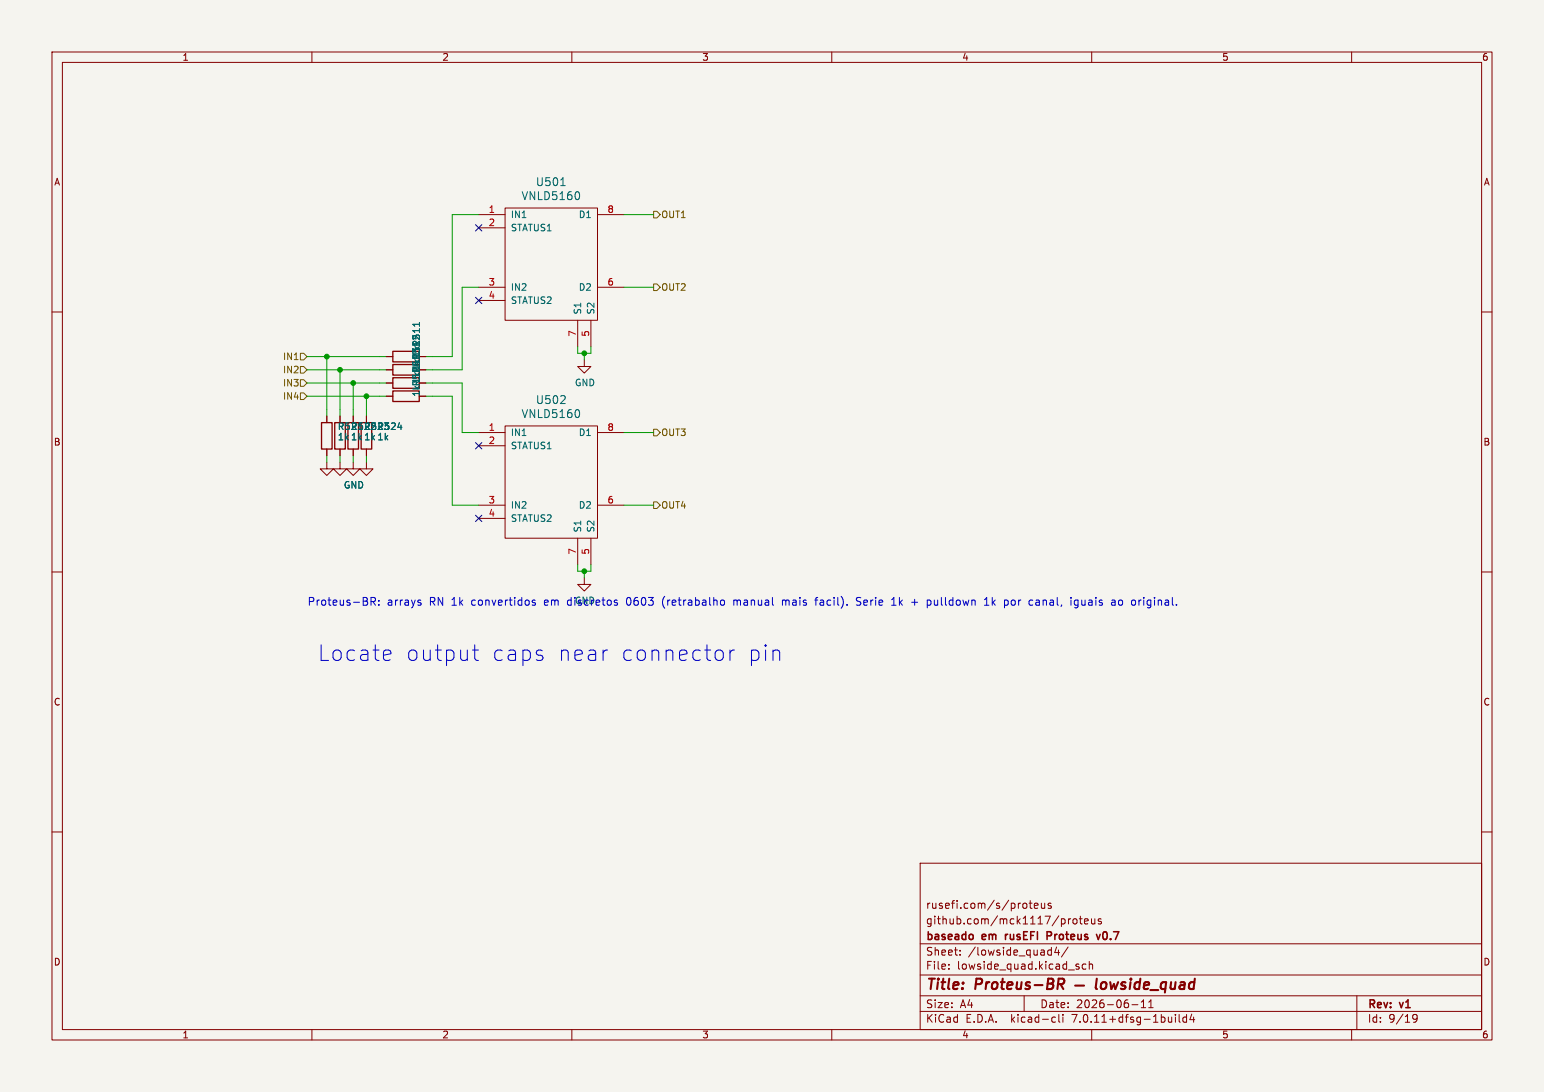
[picture p9: page 9]

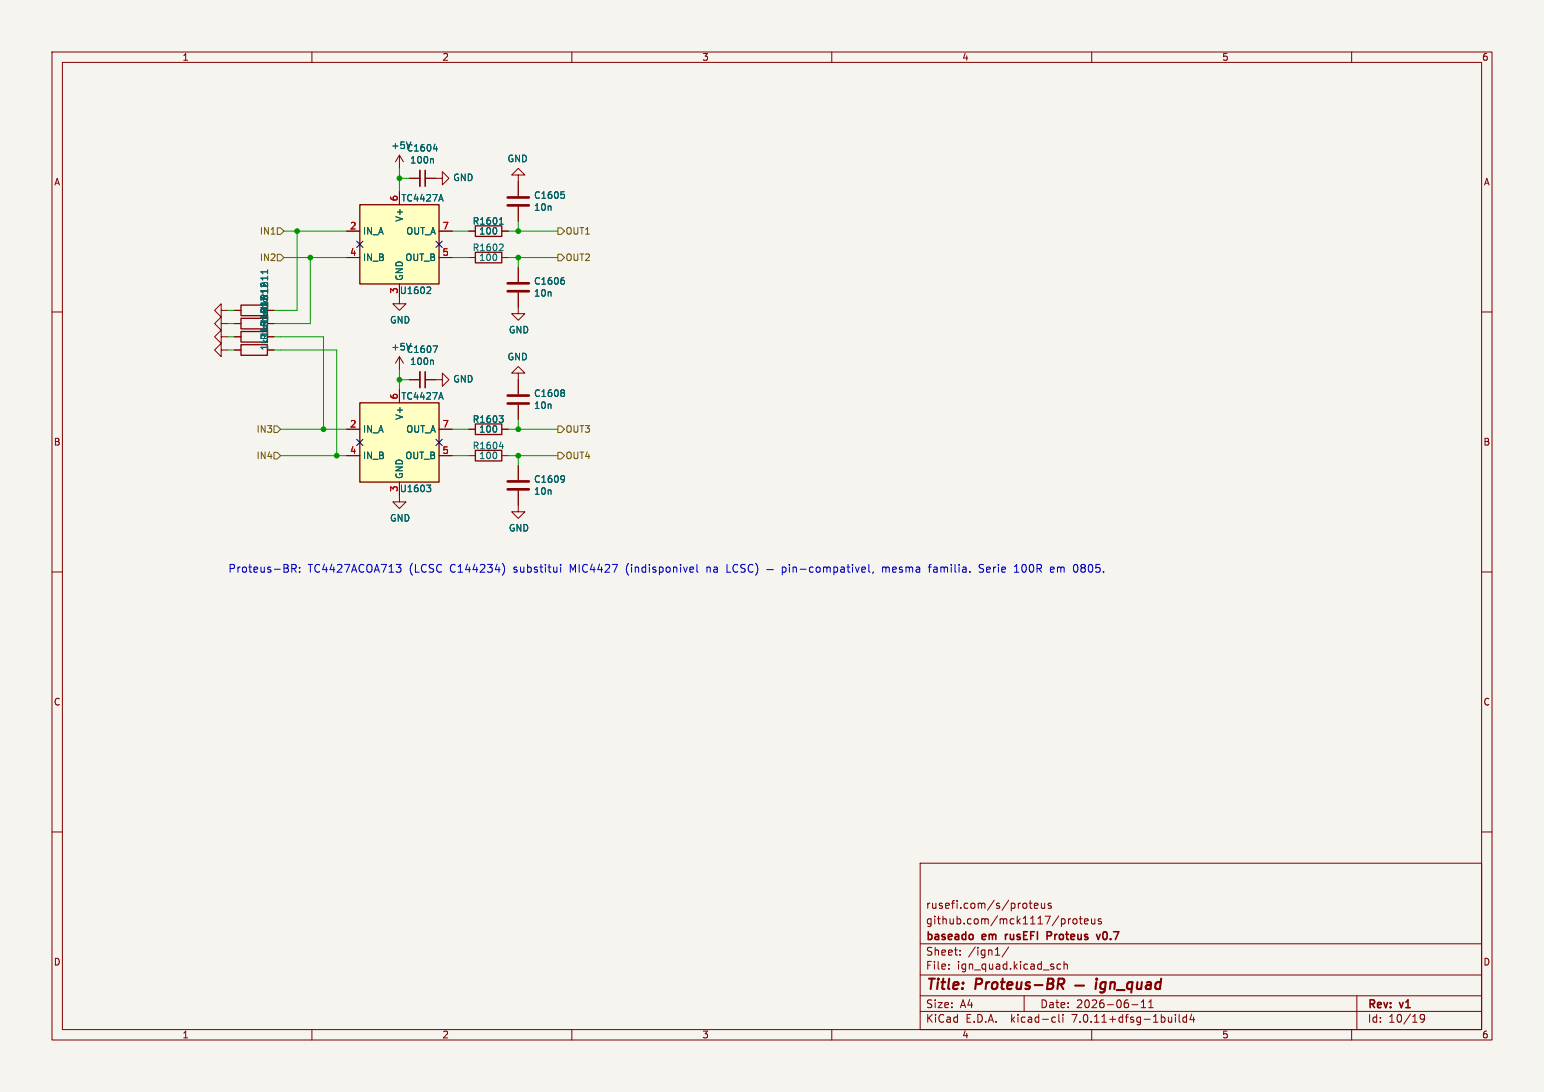
[picture p10: page 10]

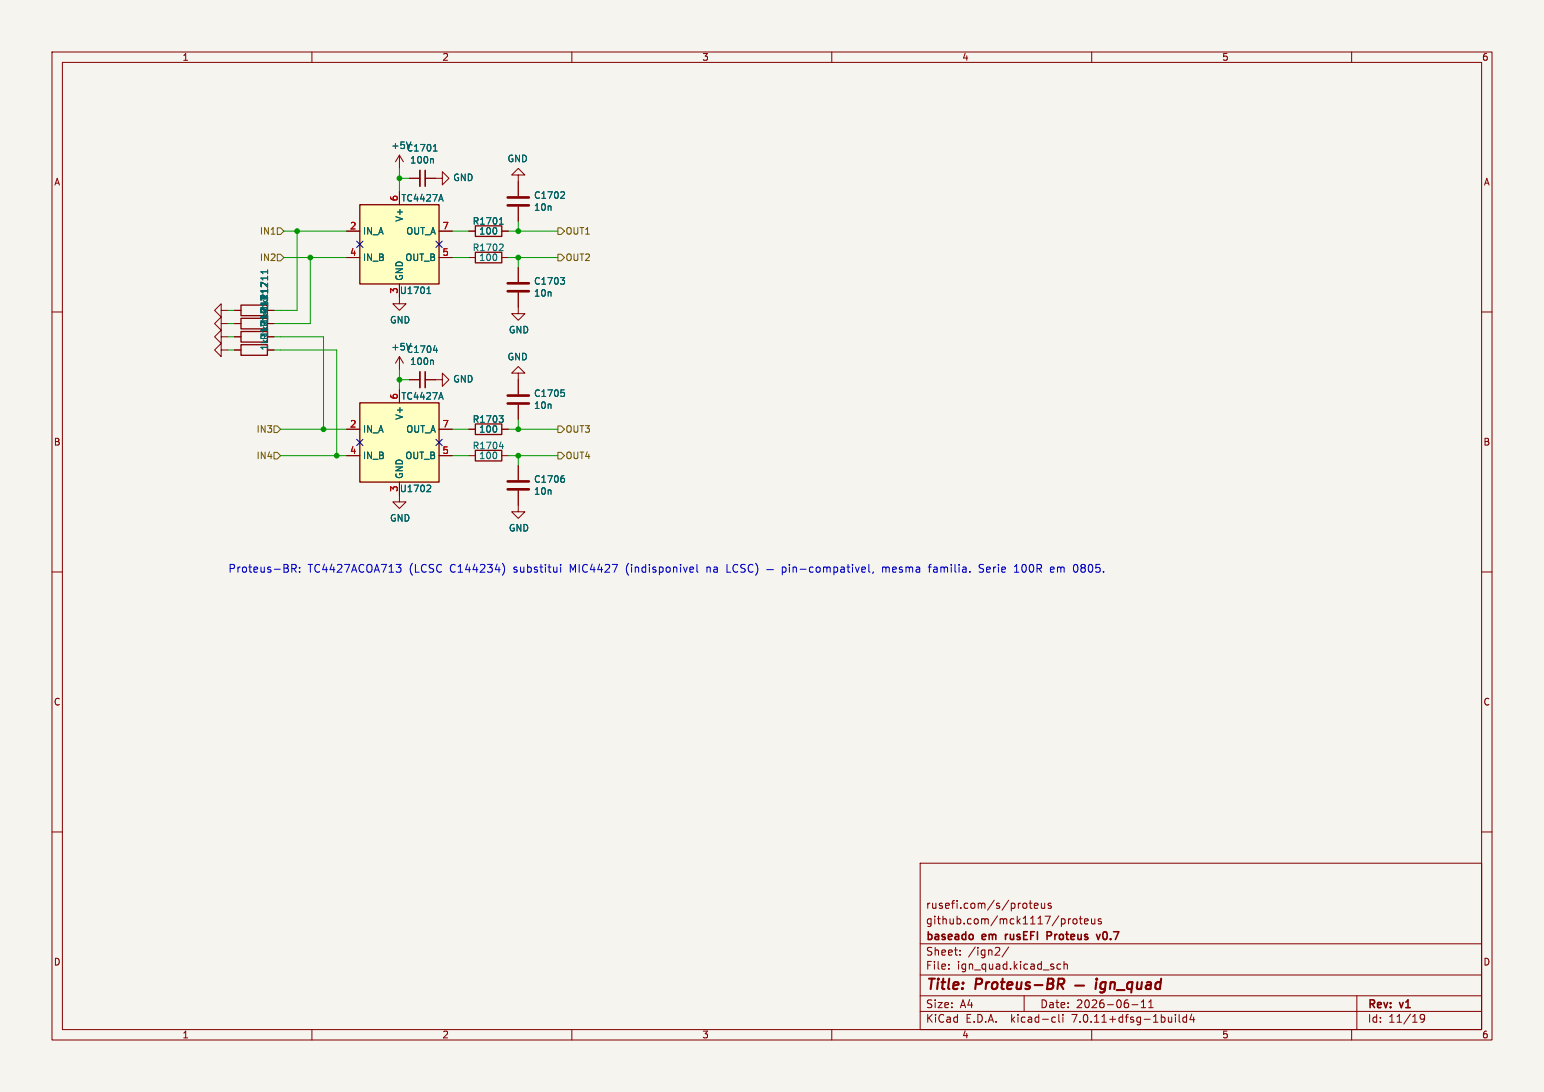
[picture p11: page 11]

rusefi.com/s/proteus GND

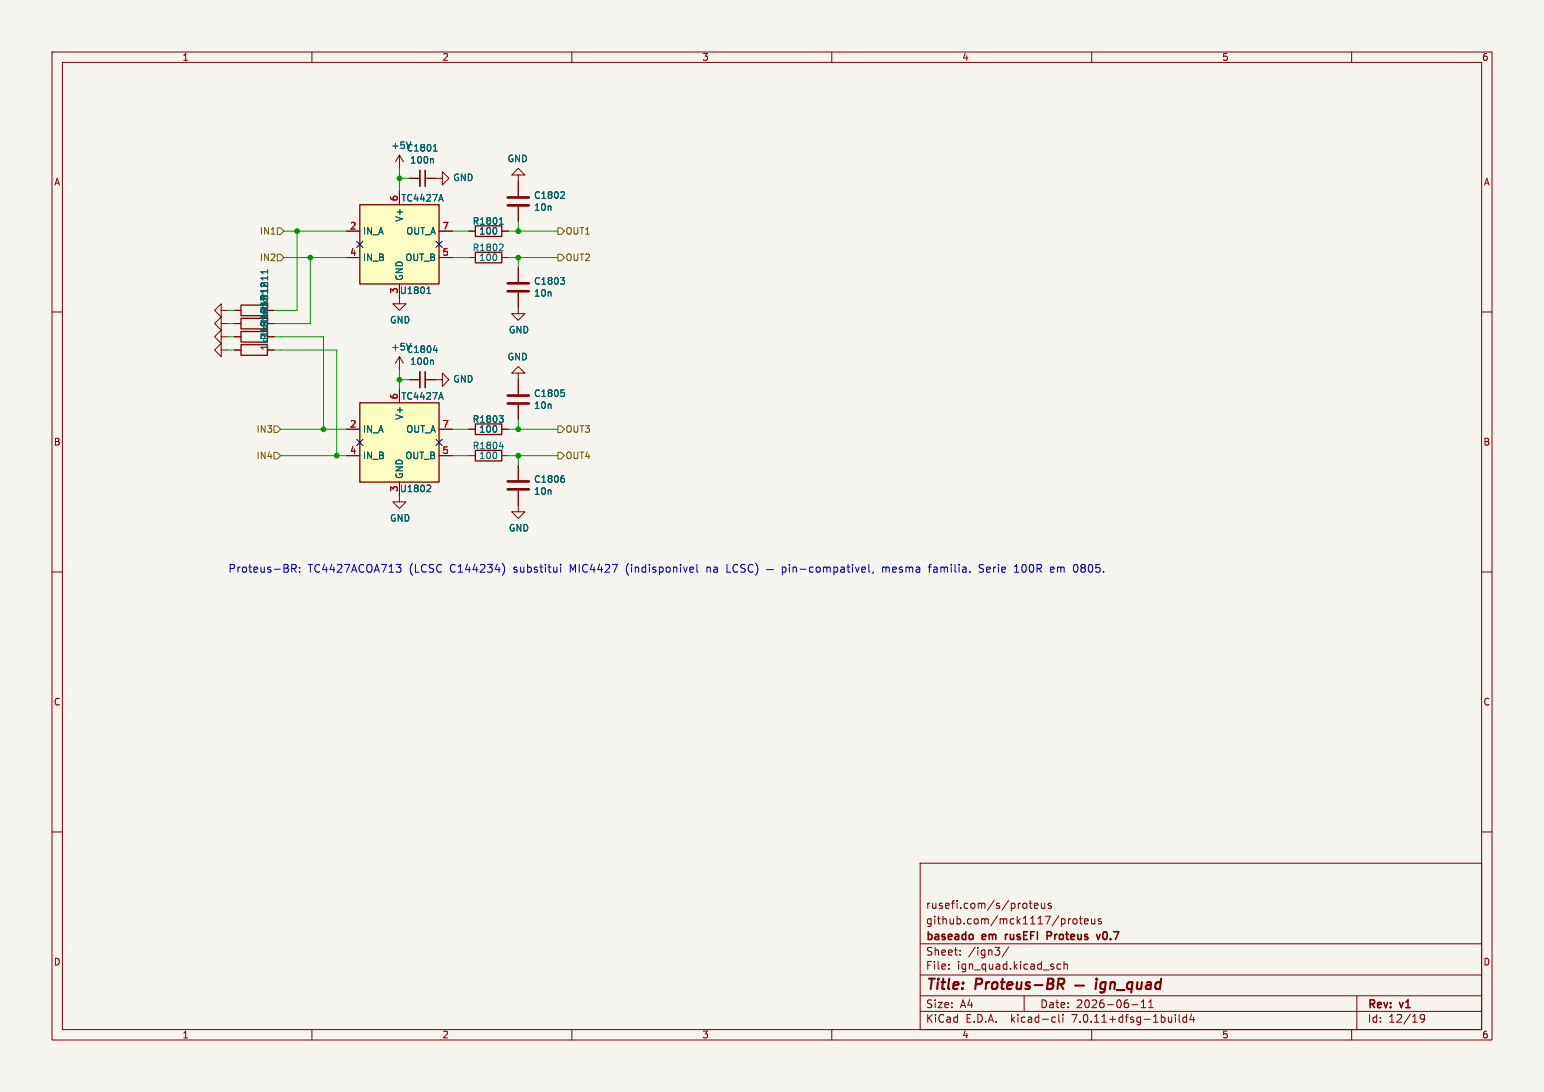
[picture p12: page 12]

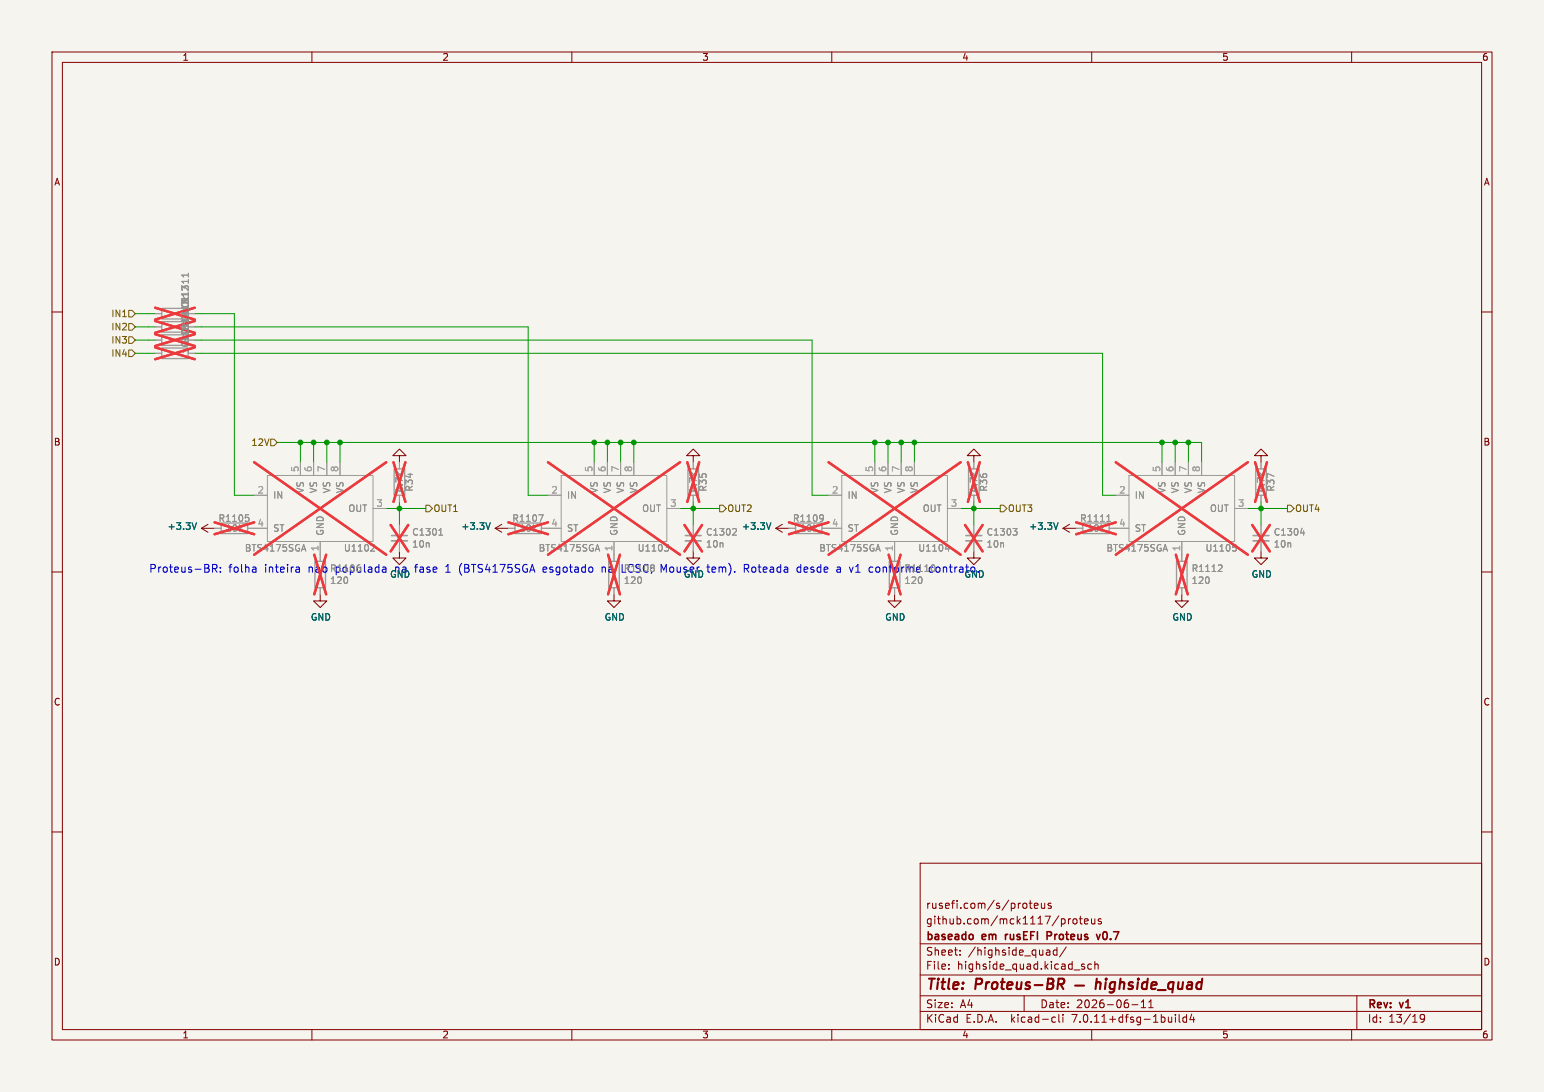
[picture p13: page 13]

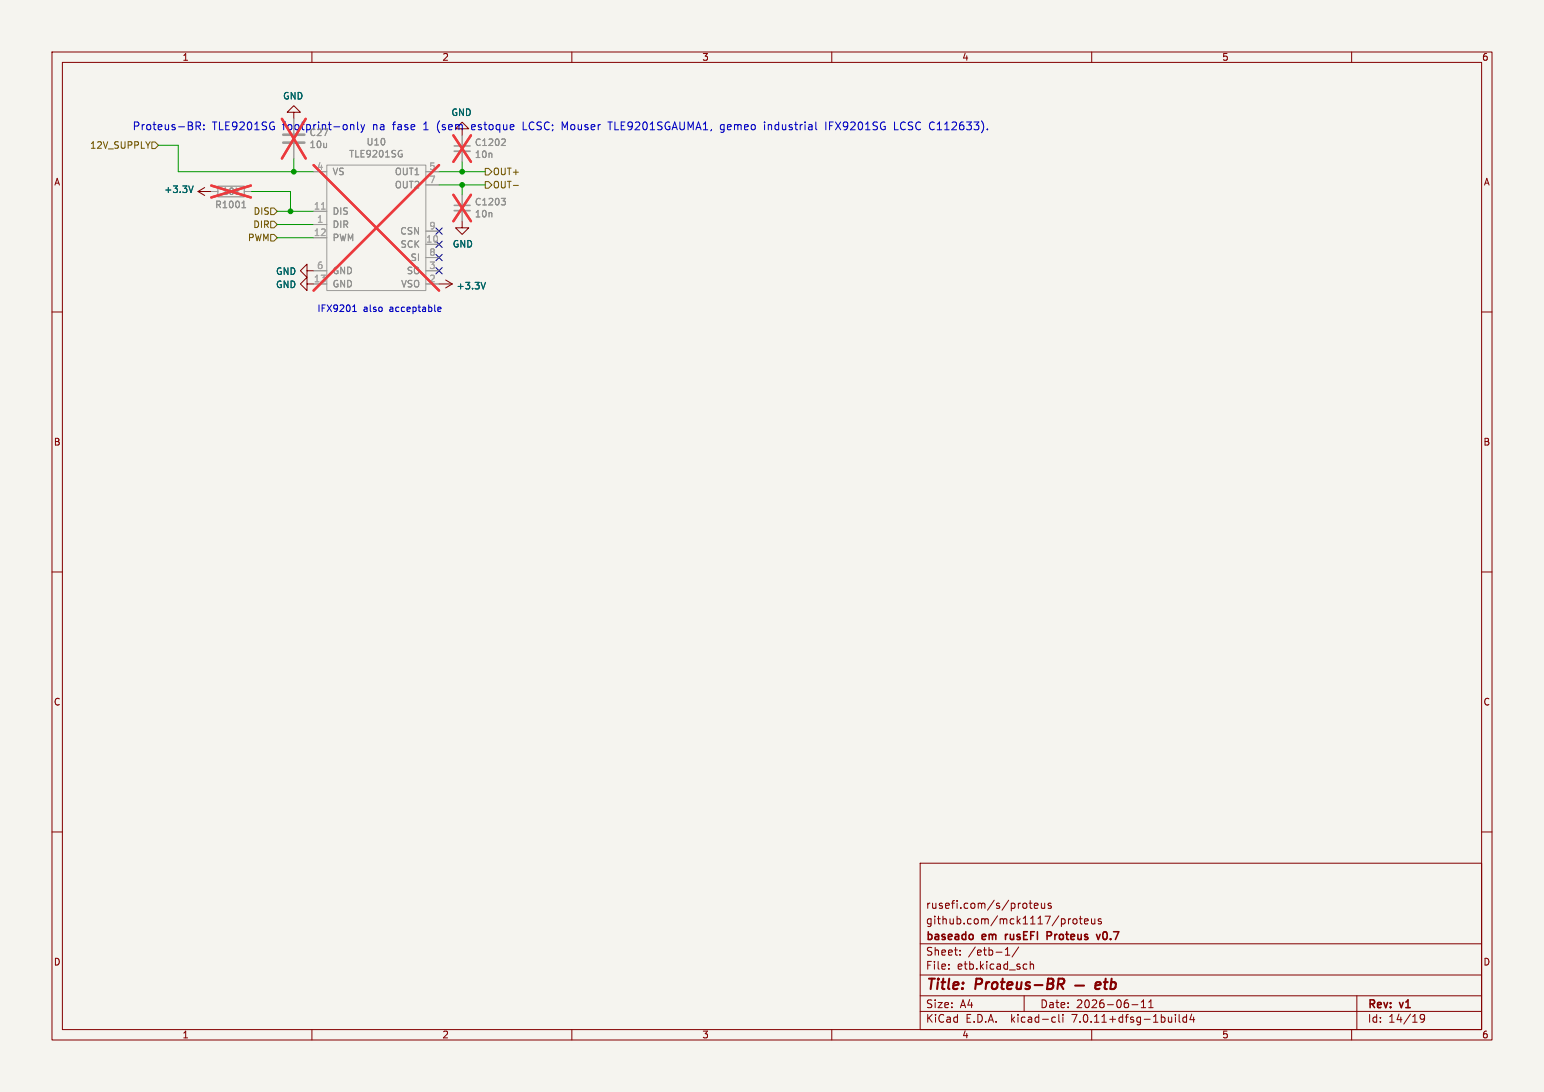
[picture p14: page 14]

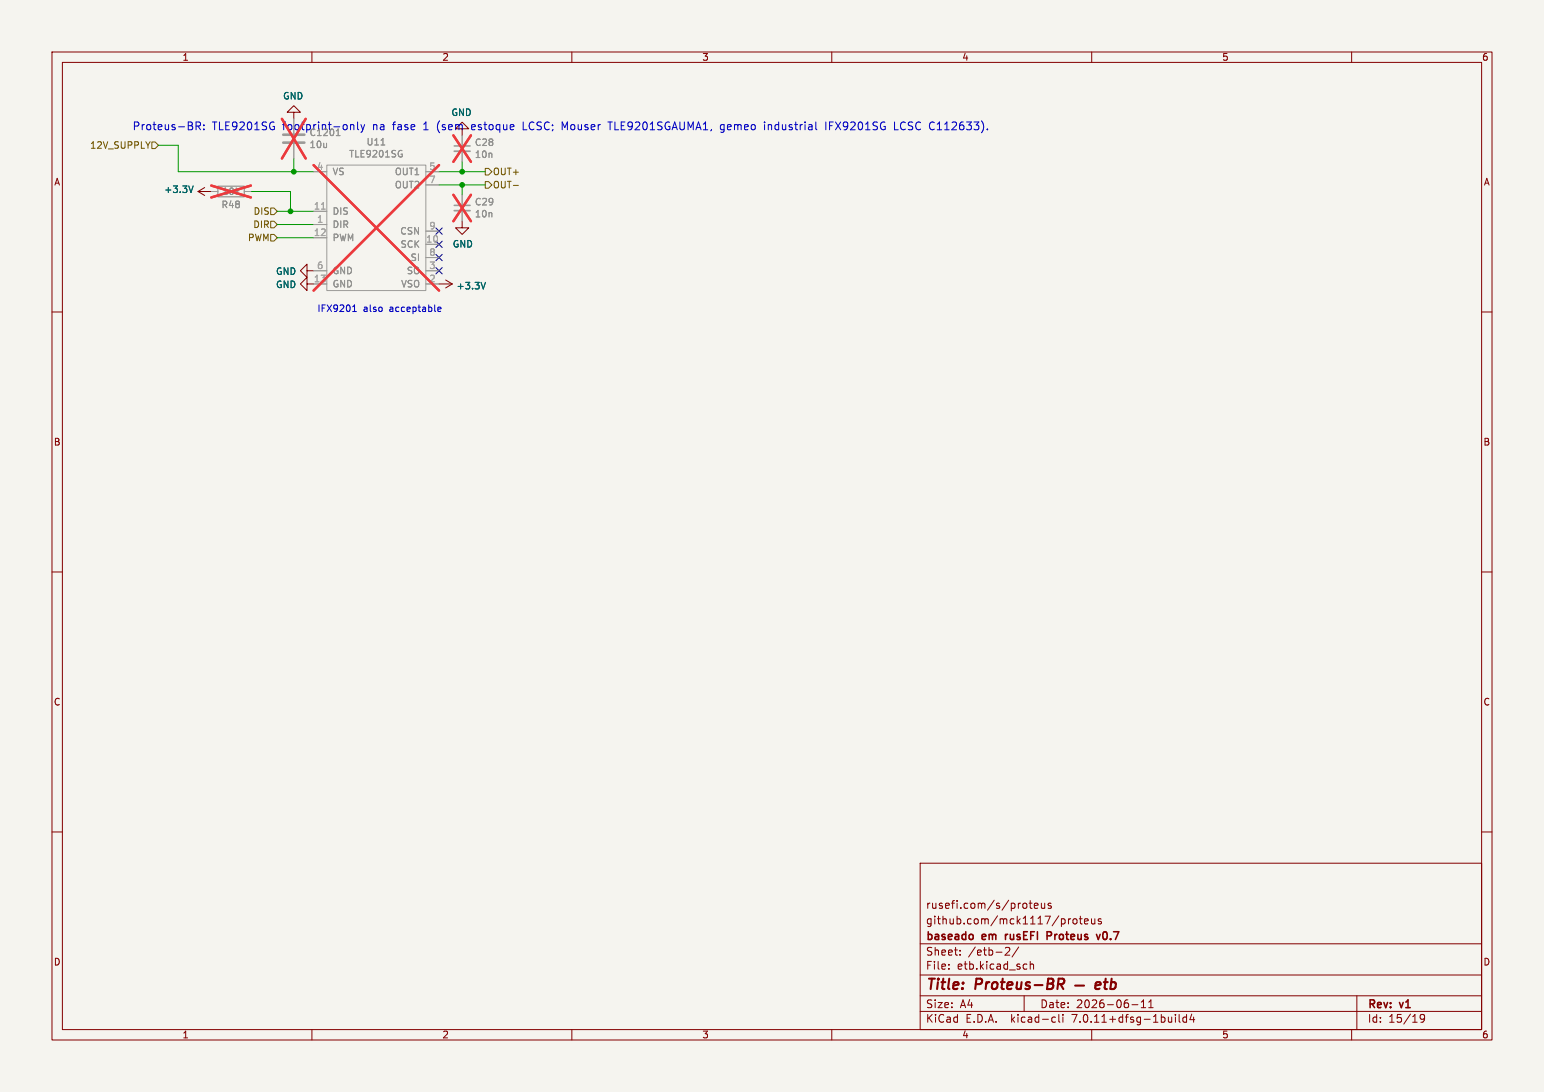
[picture p15: page 15]

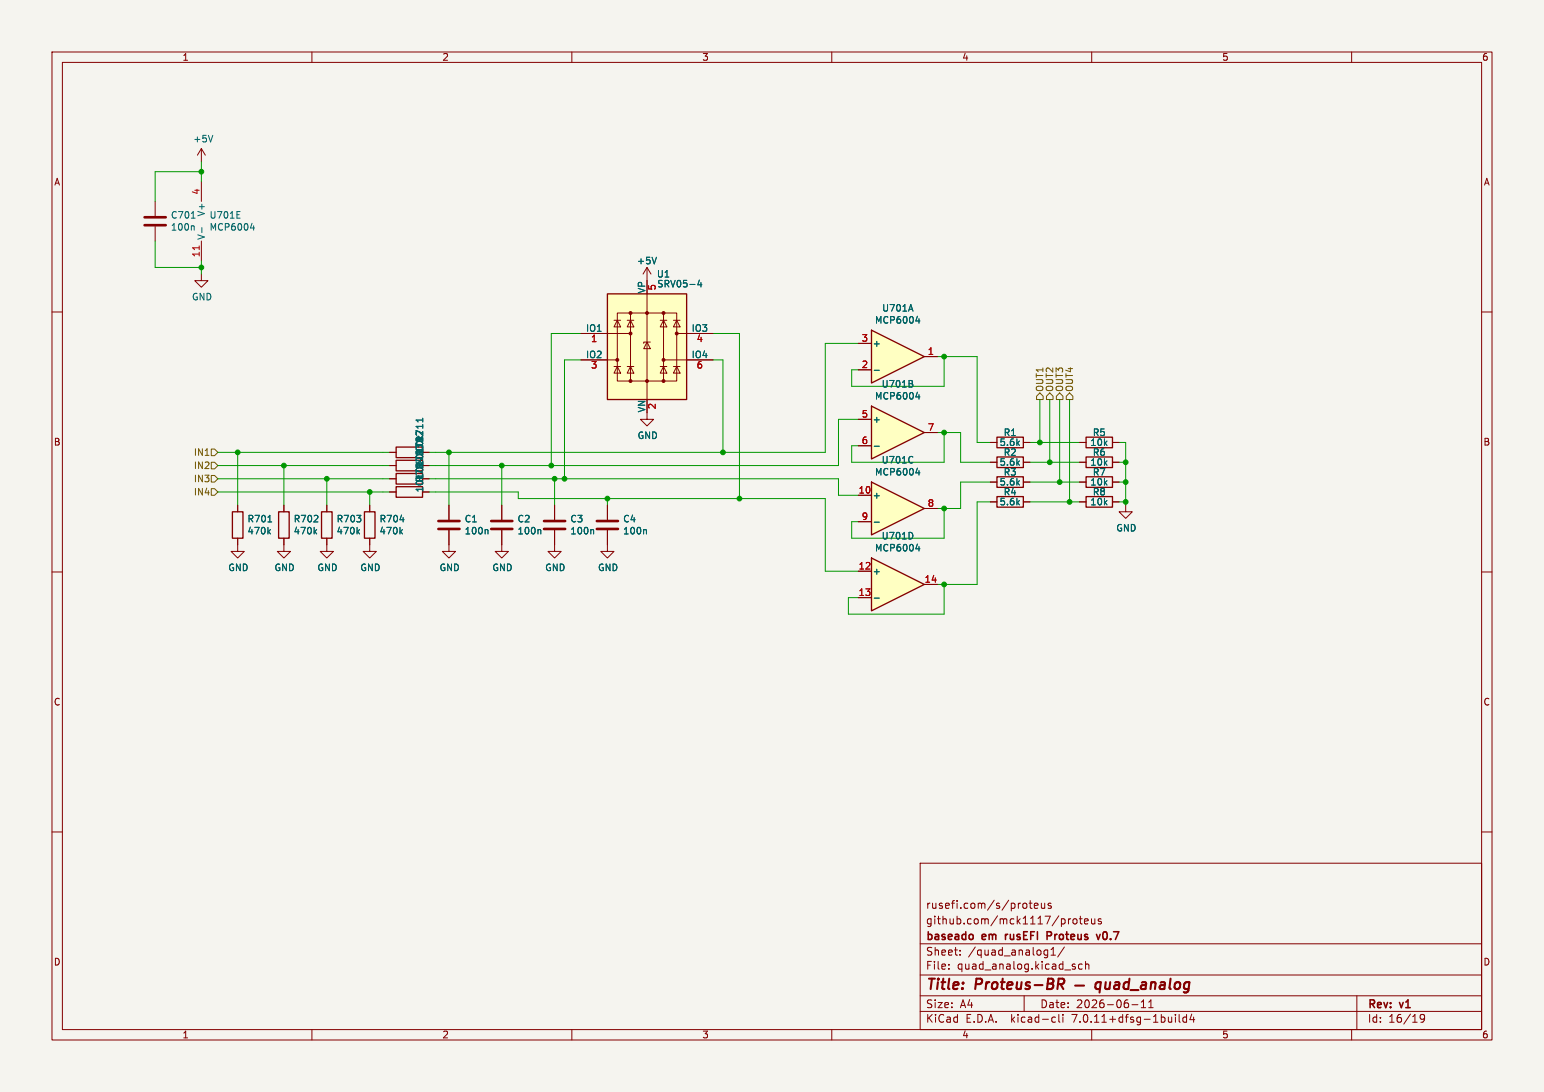
[picture p16: page 16]

rusefi.com/s/proteus GND

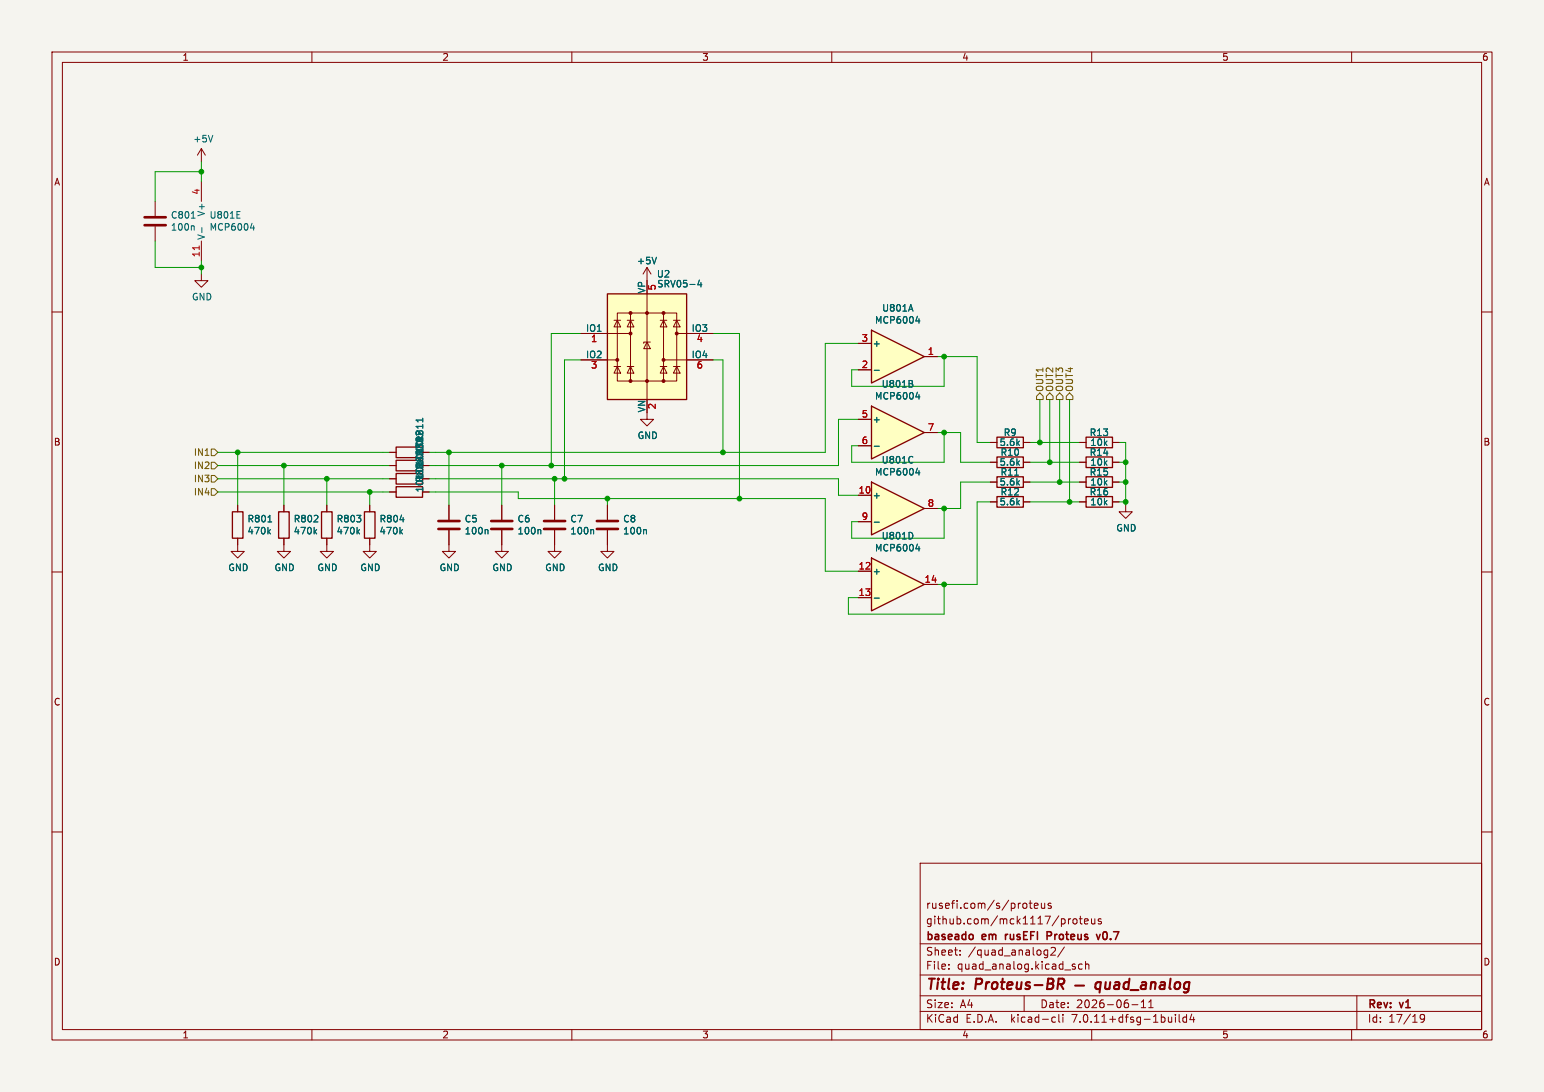
[picture p17: page 17]

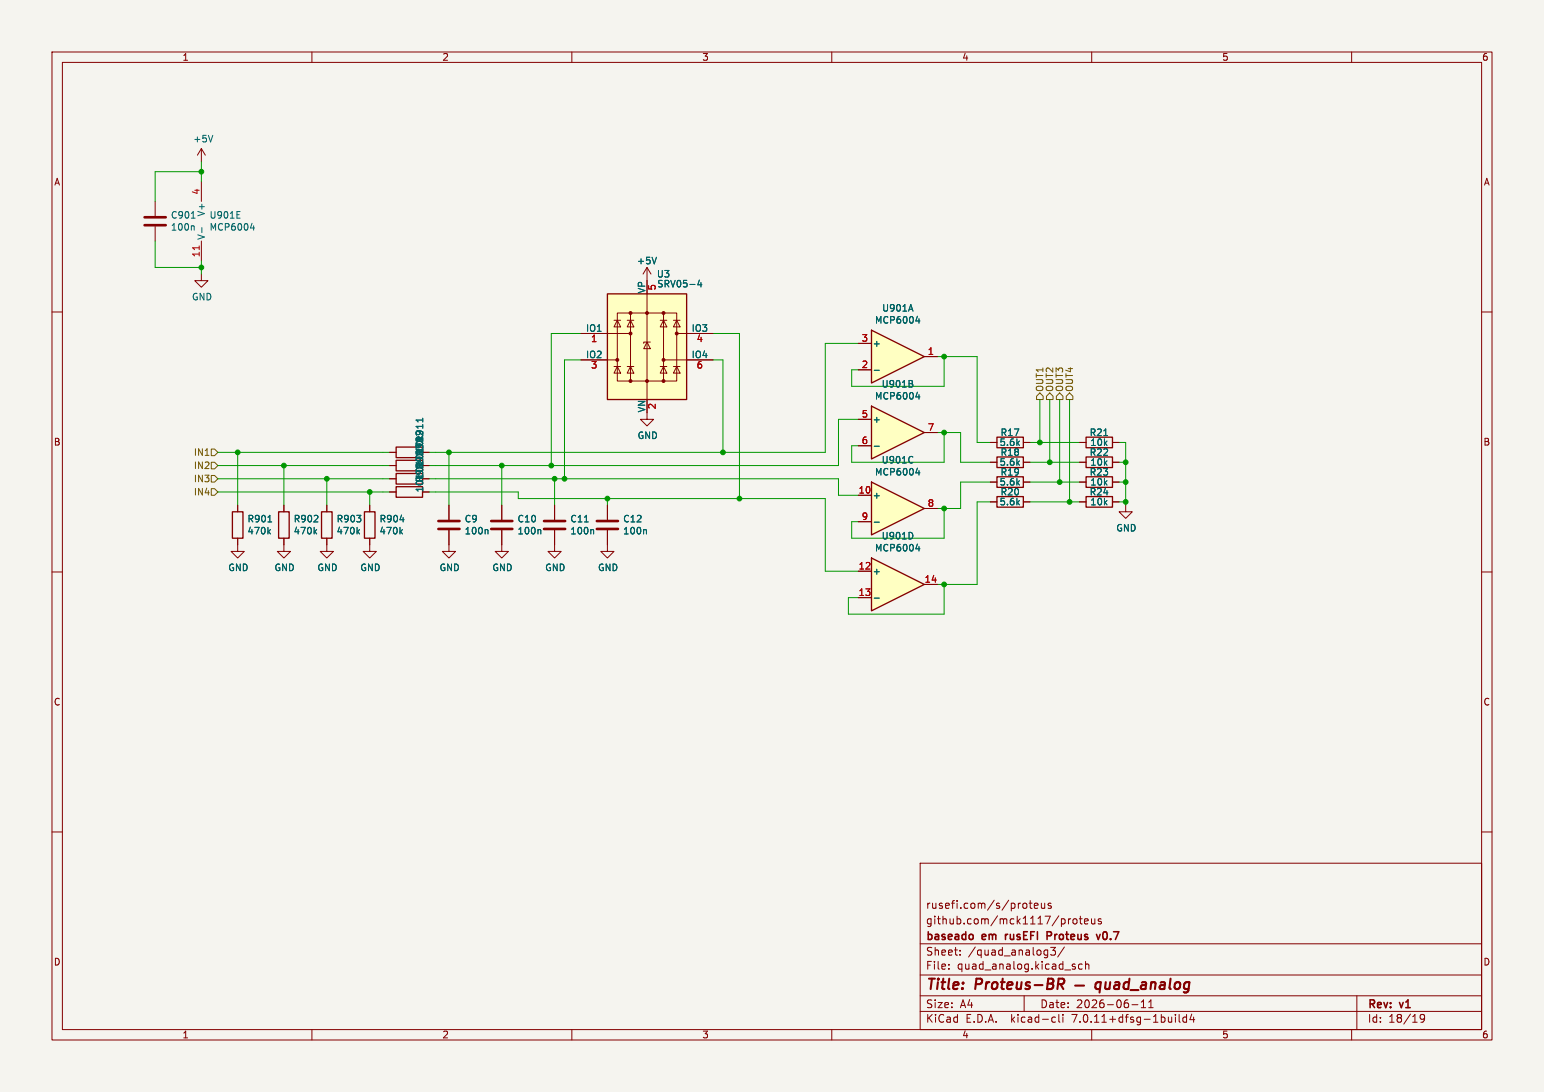
[picture p18: page 18]

rusefi.com/s/proteus GND

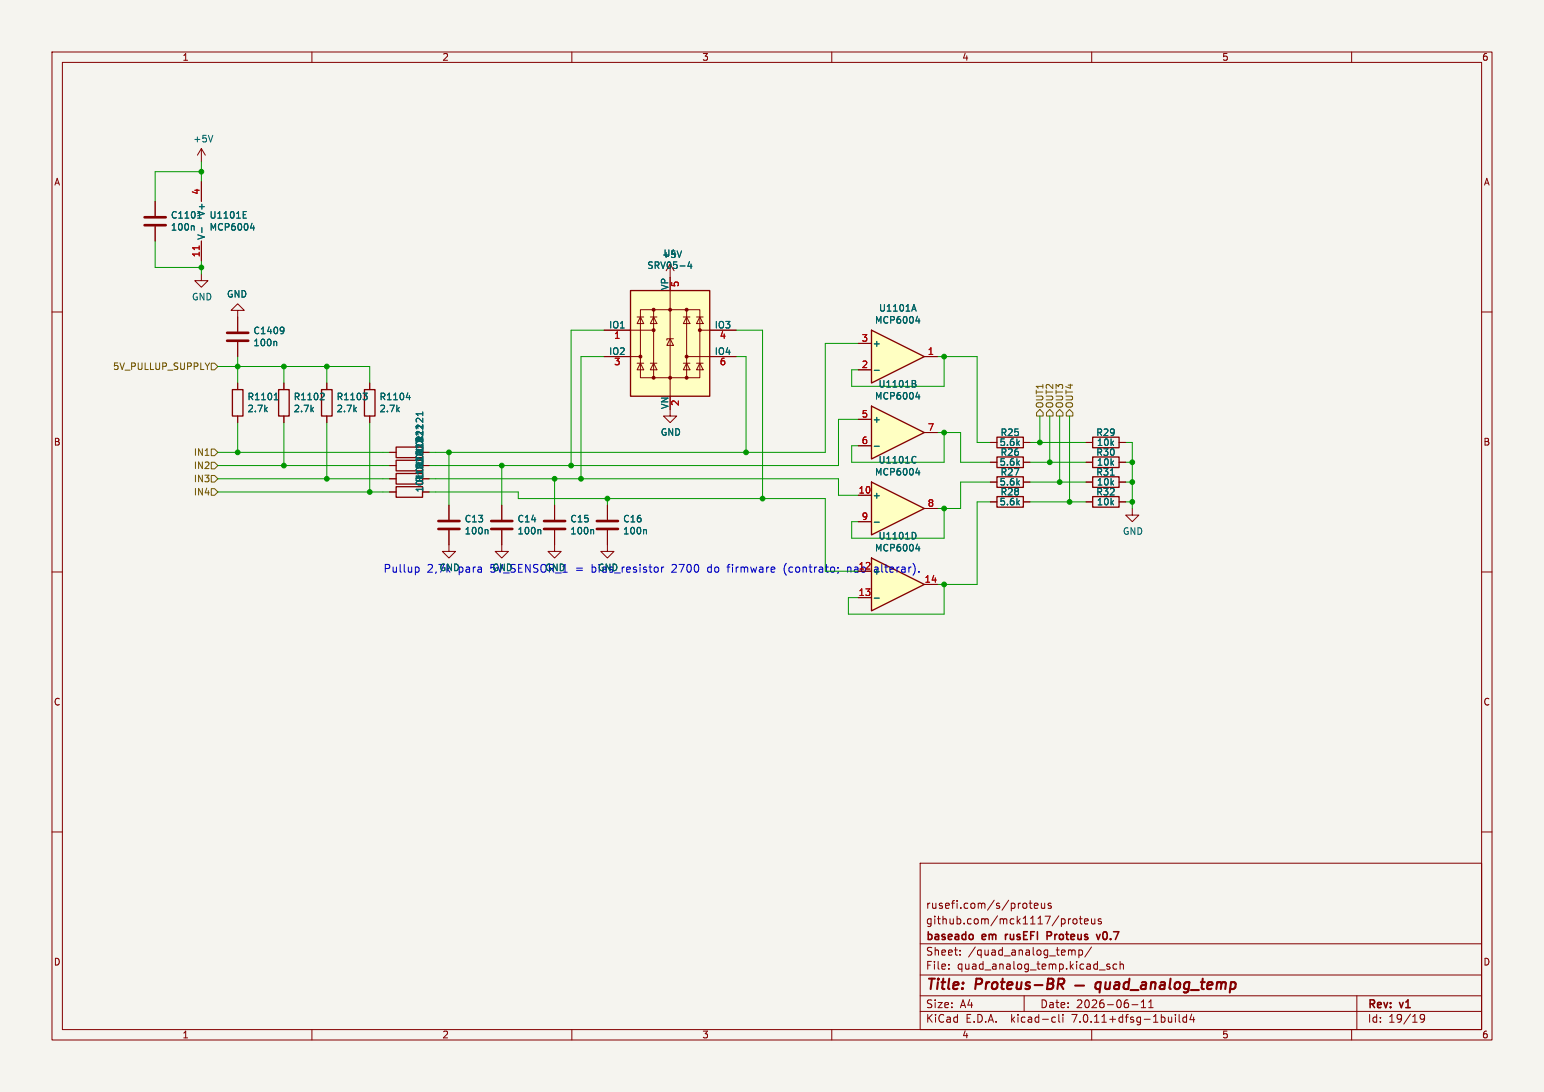
[picture p19: page 19]
