ferraritobias/proteus/hardware/proteus-br/etb.kicad_sch

## KiCad design hardware/proteus-br/etb.kicad_sch (2026-06-11)

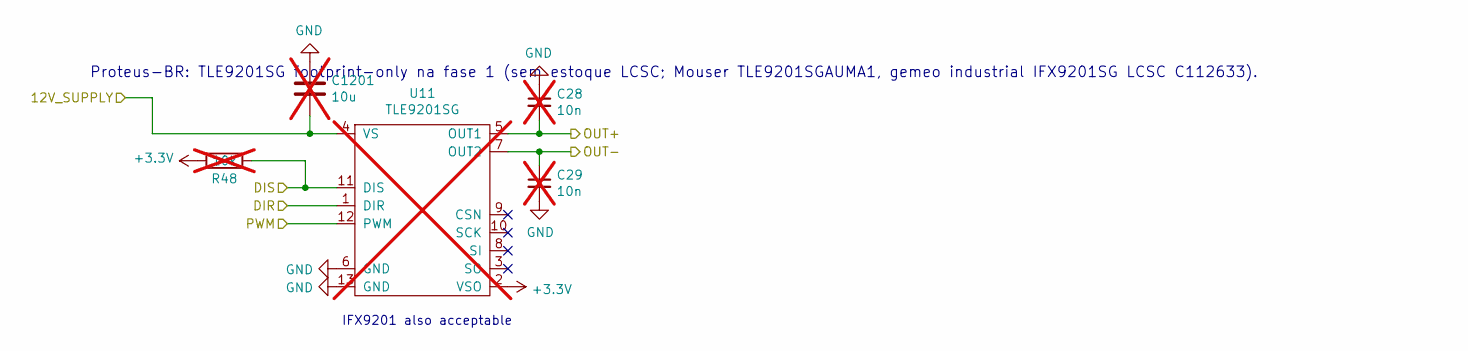
[picture p20: schematic etb.kicad_sch]

Parts:
C28, C29: 10n; C_0603_1608Metric; LCSC C57112; not fitted
C1201: 10u; C_1206_3216Metric; LCSC C13585; not fitted
R48: 10k; R_0603_1608Metric; LCSC C25744; not fitted
U11: TLE9201SG; Infineon_PG-DSO-12-9; MPN TLE9201SGAUMA1; LCSC C112633; not fitted

Connections:
12V_SUPPLY: C1201.2, U11.4 (VS)
+3.3V: R48.2, U11.2 (VSO)
DIR: U11.1 (DIR)
DIS: R48.1, U11.11 (DIS)
GND: C28.1, C29.2, C1201.1, U11.6 (GND), U11.13 (GND)
OUT+: C28.2, U11.5 (OUT1)
OUT-: C29.1, U11.7 (OUT2)
PWM: U11.12 (PWM)

Notes on the sheet:
IFX9201 also acceptable
Proteus-BR: TLE9201SG footprint-only na fase 1 (sem estoque LCSC; Mouser TLE9201SGAUMA1, gemeo industrial IFX9201SG LCSC C112633).
