ferraritobias/proteus/hardware/proteus-br/ign_quad.kicad_sch

## KiCad design hardware/proteus-br/ign_quad.kicad_sch (2026-06-11)

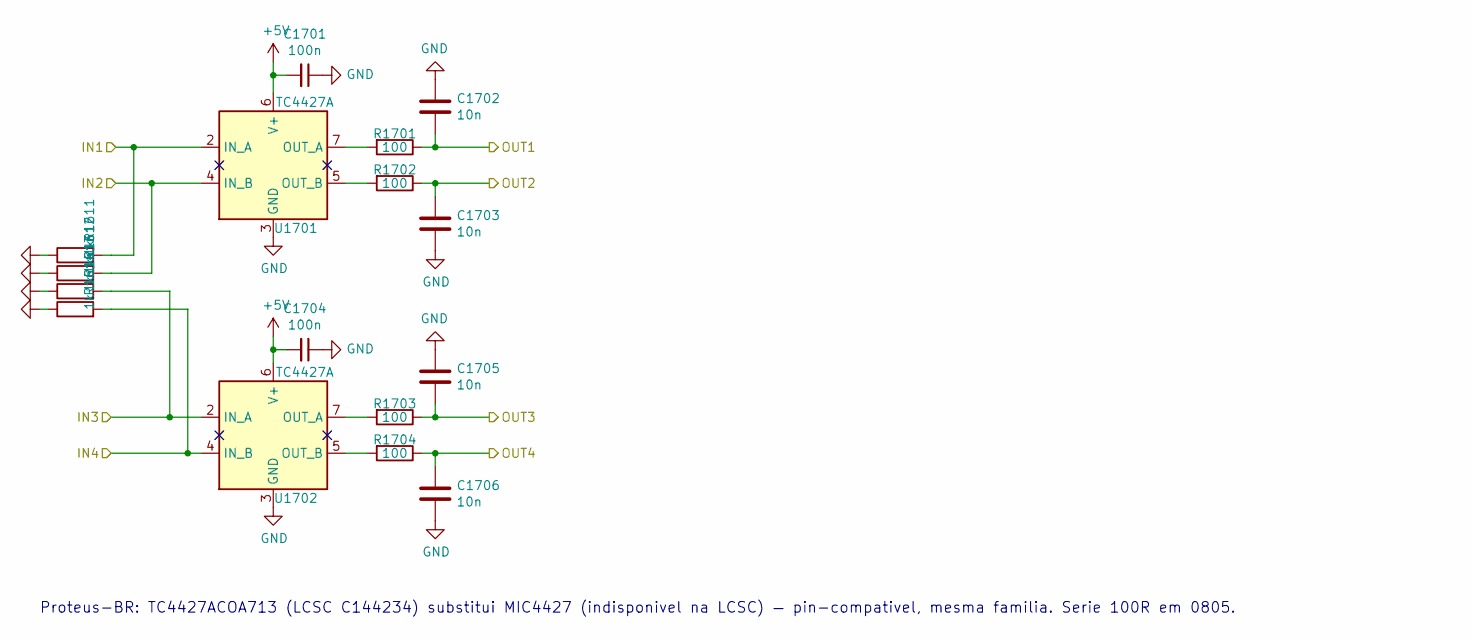
[picture p22: schematic ign_quad.kicad_sch]

Parts:
C1701, C1704: 100n; C_0603_1608Metric; LCSC C14663
C1702, C1703, C1705, C1706: 10n; C_0603_1608Metric; LCSC C57112
R1611, R1612, R1613, R1614: 1k; R_0603_1608Metric
R1701, R1702, R1703, R1704: 100; R_0805_2012Metric; LCSC C17408
U1701, U1702: TC4427A; SOIC-8_3.9x4.9mm_P1.27mm; MPN TC4427ACOA713; LCSC C144234

Connections:
+5V: C1701.2, C1704.2, U1701.6 (V+), U1702.6 (V+)
GND: C1701.1, C1702.2, C1703.2, C1704.1, C1705.2, C1706.2, R1611.1, R1612.1, R1613.1, R1614.1, U1701.3 (GND), U1702.3 (GND)
IN1: R1611.2, U1701.2 (IN_A)
IN2: R1612.2, U1701.4 (IN_B)
IN3: R1613.2, U1702.2 (IN_A)
IN4: R1614.2, U1702.4 (IN_B)
unnamed: R1701.2, U1701.7 (OUT_A)
unnamed: R1702.2, U1701.5 (OUT_B)
unnamed: R1703.2, U1702.7 (OUT_A)
unnamed: R1704.2, U1702.5 (OUT_B)
OUT1: C1702.1, R1701.1
OUT2: C1703.1, R1702.1
OUT3: C1705.1, R1703.1
OUT4: C1706.1, R1704.1

Notes on the sheet:
Proteus-BR: TC4427ACOA713 (LCSC C144234) substitui MIC4427 (indisponivel na LCSC) — pin-compativel, mesma familia. Serie 100R em 0805.
