ferraritobias/proteus/hardware/proteus-br/knock.kicad_sch

## KiCad design hardware/proteus-br/knock.kicad_sch (2026-06-11)

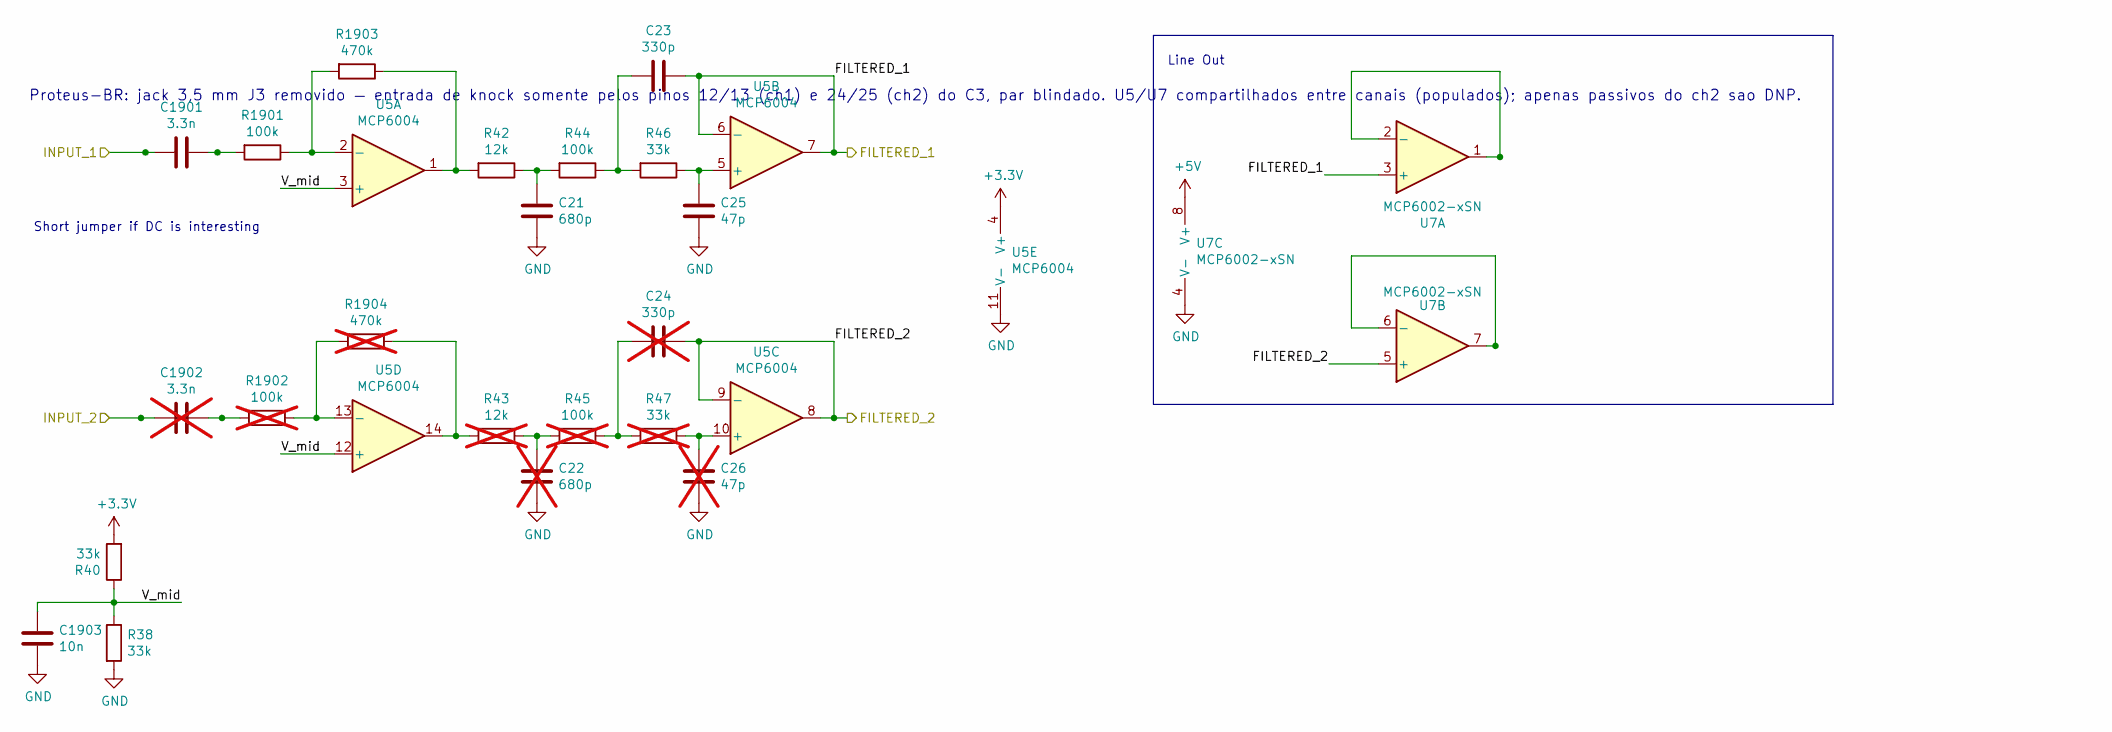
[picture p23: schematic knock.kicad_sch]

Parts:
C21: 680p; C_0603_1608Metric; LCSC C1630
C22: 680p; C_0603_1608Metric; LCSC C1630; not fitted
C23: 330p; C_0603_1608Metric; LCSC C13533
C24: 330p; C_0603_1608Metric; LCSC C13533; not fitted
C25: 47p; C_0603_1608Metric; LCSC C1567
C26: 47p; C_0603_1608Metric; LCSC C1567; not fitted
C1901: 3.3n; C_0805_2012Metric; LCSC C53175
C1902: 3.3n; C_0805_2012Metric; LCSC C53175; not fitted
C1903: 10n; C_0603_1608Metric; LCSC C57112
R38, R40, R46: 33k; R_0603_1608Metric; LCSC C25779
R42: 12k; R_0603_1608Metric; LCSC C25752
R43: 12k; R_0603_1608Metric; LCSC C25752; not fitted
R44, R1901: 100k; R_0603_1608Metric; LCSC C25741
R45, R1902: 100k; R_0603_1608Metric; LCSC C25741; not fitted
R47: 33k; R_0603_1608Metric; LCSC C25779; not fitted
R1903: 470k; R_0603_1608Metric; LCSC C25790
R1904: 470k; R_0603_1608Metric; LCSC C25790; not fitted
U5: MCP6004; TSSOP-14_4.4x5mm_P0.65mm; MPN MCP6004-I/SL; LCSC C7378
U7: MCP6002-xSN; SOIC-8_3.9x4.9mm_P1.27mm; MPN MCP6002-I/SN; LCSC C7377

Connections:
+3.3V: R40.2, U5.4 (V+)
+5V: U7.8 (V+)
FILTERED_1: C23.2, U5.6 (-), U5.7, U7.3 (+)
FILTERED_2: C24.2, U5.8, U5.9 (-), U7.5 (+)
GND: C21.1, C22.1, C25.1, C26.1, C1903.1, R38.2, U5.11 (V-), U7.4 (V-)
INPUT_1: C1901.2
INPUT_2: C1902.2
unnamed: C21.2, R42.1, R44.2
unnamed: C22.2, R43.1, R45.2
unnamed: C23.1, R44.1, R46.2
unnamed: C24.1, R45.1, R47.2
unnamed: C25.2, R46.1, U5.5 (+)
unnamed: C26.2, R47.1, U5.10 (+)
unnamed: C1901.1, R1901.2
unnamed: C1902.1, R1902.2
unnamed: R1901.1, R1903.2, U5.2 (-)
unnamed: R1902.1, R1904.2, U5.13 (-)
unnamed: R42.2, R1903.1, U5.1
unnamed: R43.2, R1904.1, U5.14
unnamed: U7.1, U7.2 (-)
unnamed: U7.6 (-), U7.7
V_mid: C1903.2, R38.1, R40.1, U5.3 (+), U5.12 (+)

Notes on the sheet:
Line Out
Short jumper if DC is interesting
Proteus-BR: jack 3,5 mm J3 removido — entrada de knock somente pelos pinos 12/13 (ch1) e 24/25 (ch2) do C3, par blindado. U5/U7 compartilhados entre canais (populados); apenas passivos do ch2 sao DNP.
