ferraritobias/proteus/hardware/proteus-br/lowside_quad.kicad_sch

## KiCad design hardware/proteus-br/lowside_quad.kicad_sch (2026-06-11)

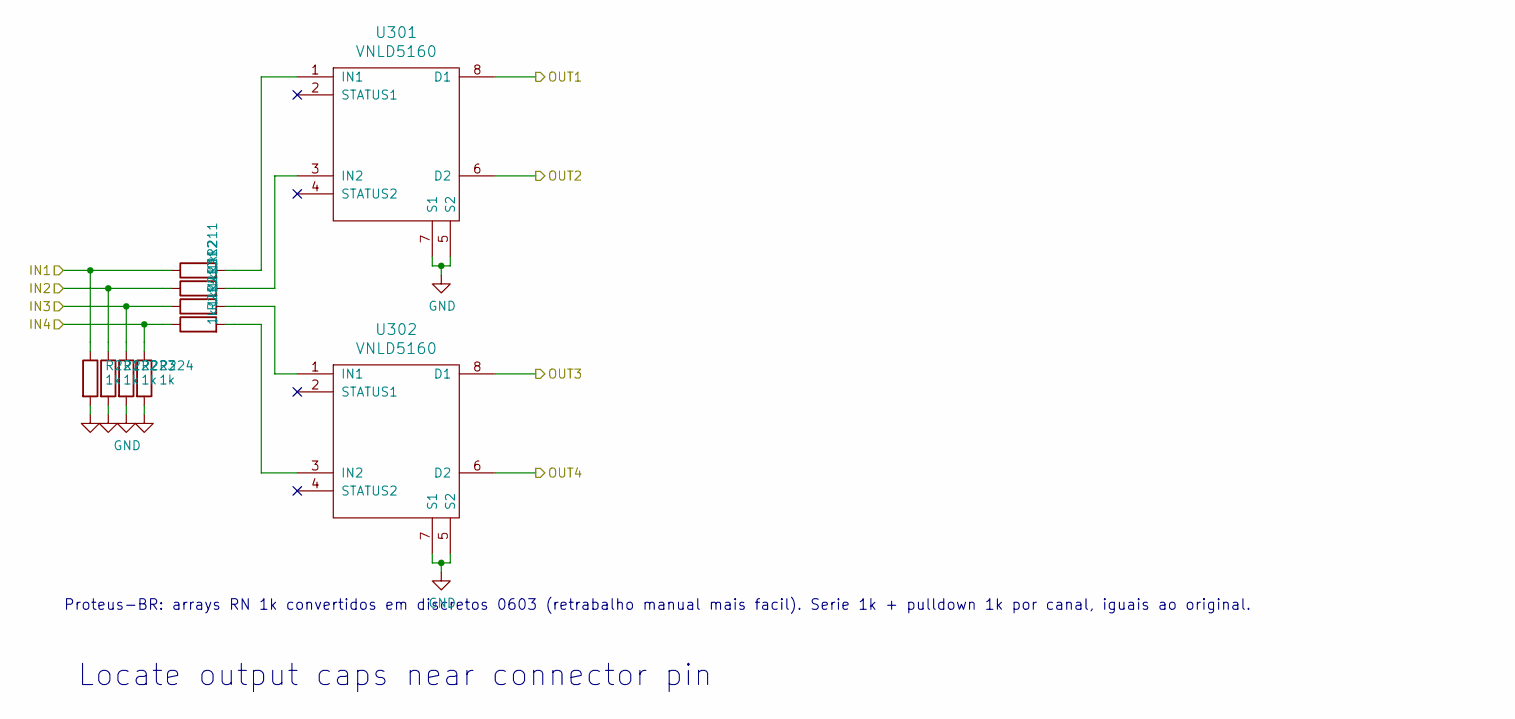
[picture p24: schematic lowside_quad.kicad_sch]

Parts:
R211, R212, R213, R214, R221, R222, R223, R224: 1k; R_0603_1608Metric
U301, U302: VNLD5160; SOIC-8_3.9x4.9mm_P1.27mm; MPN VNLD5160TR-E; LCSC C377942

Connections:
GND: R221.2, R222.2, R223.2, R224.2, U301.5 (S2), U301.7 (S1), U302.5 (S2), U302.7 (S1)
IN1: R211.1, R221.1
IN2: R212.1, R222.1
IN3: R213.1, R223.1
IN4: R214.1, R224.1
unnamed: R211.2, U301.1 (IN1)
unnamed: R212.2, U301.3 (IN2)
unnamed: R213.2, U302.1 (IN1)
unnamed: R214.2, U302.3 (IN2)
OUT1: U301.8 (D1)
OUT2: U301.6 (D2)
OUT3: U302.8 (D1)
OUT4: U302.6 (D2)

Notes on the sheet:
Locate output caps near connector pin
Proteus-BR: arrays RN 1k convertidos em discretos 0603 (retrabalho manual mais facil). Serie 1k + pulldown 1k por canal, iguais ao original.
