ferraritobias/proteus/hardware/proteus-br/mcu.kicad_sch

## KiCad design hardware/proteus-br/mcu.kicad_sch (2026-06-11)

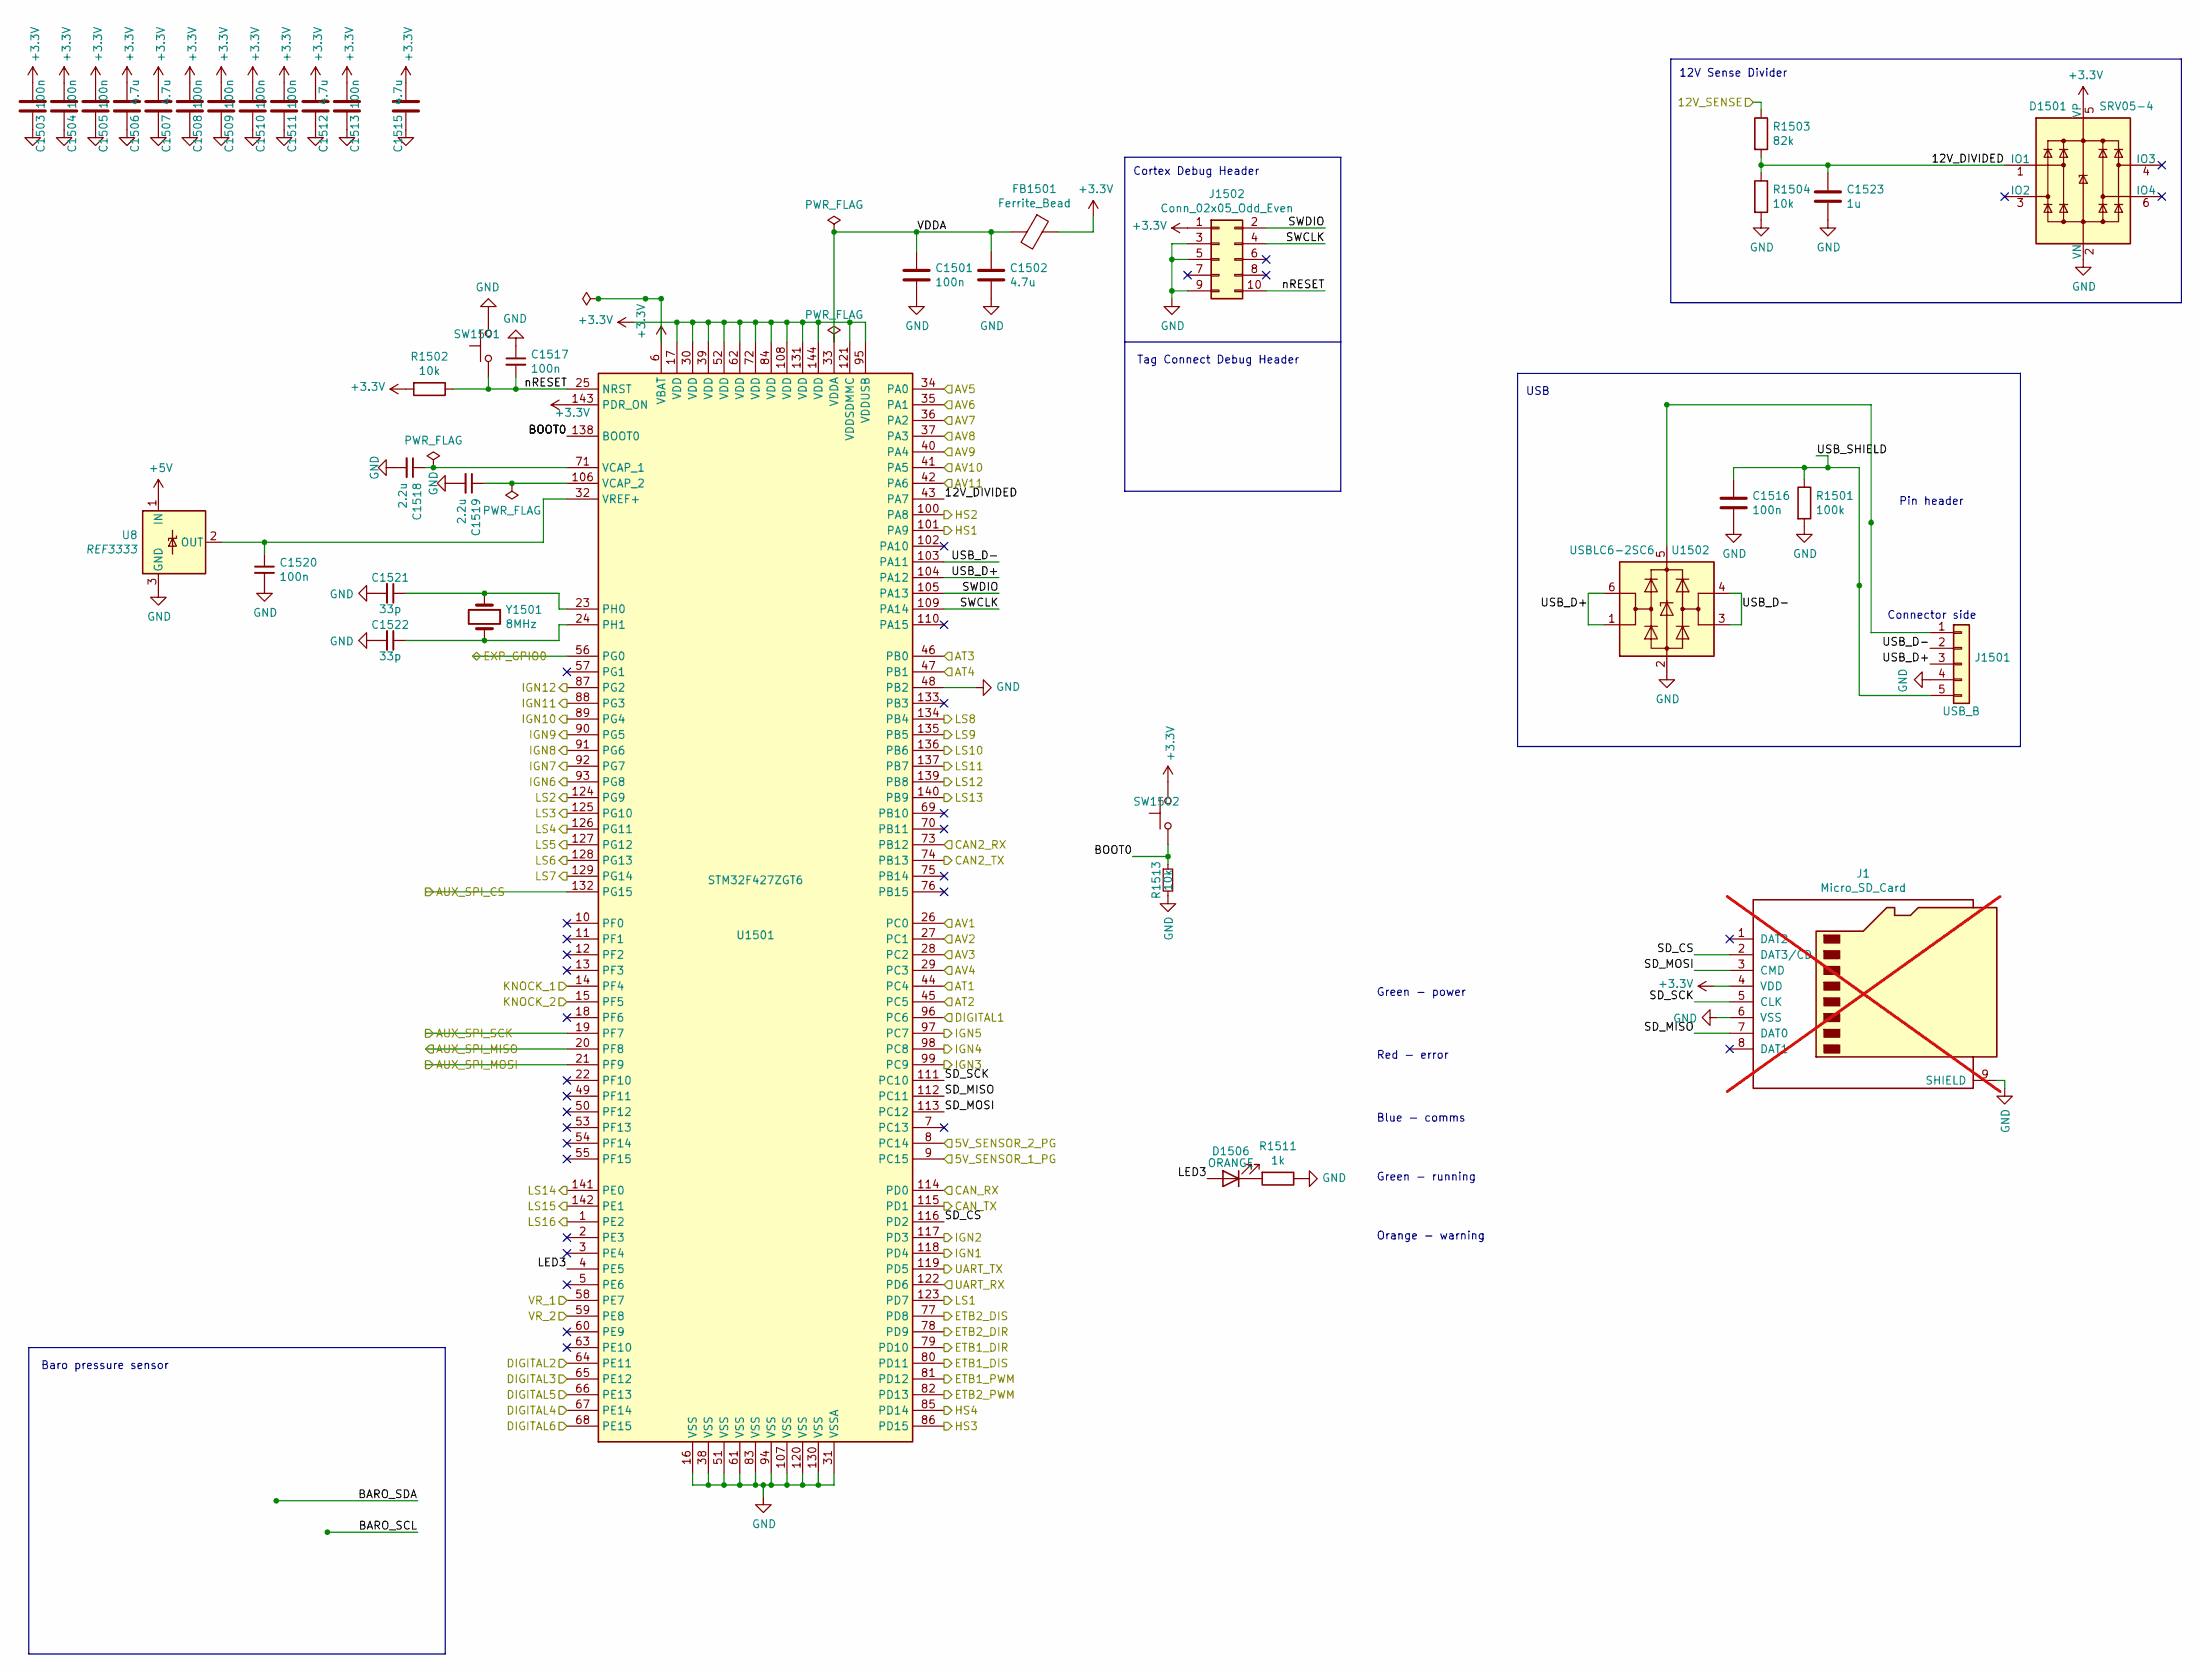
[picture p25: schematic mcu.kicad_sch]

Parts:
C1501, C1503, C1504, C1505, C1508, C1509, C1510, C1511, C1513, C1516, C1517, C1520: 100n; C_0603_1608Metric; LCSC C14663
C1502, C1506, C1507, C1512, C1515: 4.7u; C_0603_1608Metric; LCSC C19666
C1518, C1519: 2.2u; C_0603_1608Metric; LCSC C23630
C1521, C1522: 33p; C_0603_1608Metric; LCSC C1562
C1523: 1u; C_0603_1608Metric; LCSC C15849
D1501: SRV05-4; SOT-23-6; MPN SRV05-4.TCT; LCSC C13612
D1506: ORANGE; LED_0603_1608Metric_Castellated; MPN KT-0603R-O; LCSC C72038
FB1501: Ferrite_Bead; L_0805_2012Metric; LCSC C1015
J1: Micro_SD_Card; microSD_HC_Wuerth_693072010801; LCSC C164170; not fitted
J1501: USB_B; USB_B_TE_5787834_Vertical; LCSC N/A
J1502: Conn_02x05_Odd_Even; PinHeader_2x05_P1.27mm_Vertical_SMD; LCSC N/A
R1501: 100k; R_0603_1608Metric; LCSC C25741
R1502, R1504, R1513: 10k; R_0603_1608Metric; LCSC C25744
R1503: 82k; R_0603_1608Metric; LCSC C23254
R1511: 1k; R_0603_1608Metric; LCSC C25104
SW1501, SW1502: SW_Push; SW_SPST_EVQQ2; LCSC C318887
U8: REF3333; SOT-23; MPN REF3333AIDBZR; LCSC C130016
U1501: STM32F427ZGT6; LQFP-144_20x20mm_P0.5mm; MPN STM32F427ZGT6; LCSC C117816
U1502: USBLC6-2SC6; SOT-23-6; MPN USBLC6-2SC6; LCSC C7519
Y1501: 8MHz; Crystal_SMD_5032-2Pin_5.0x3.2mm; MPN X50328MSB2GI; LCSC C115962

Connections:
5V_SENSOR_1_PG: U1501.9 (PC15)
5V_SENSOR_2_PG: U1501.8 (PC14)
12V_DIVIDED: C1523.1, D1501.1 (IO1), R1503.2, R1504.1, U1501.43 (PA7)
12V_SENSE: R1503.1
+3.3V: C1503.2, C1504.2, C1505.2, C1506.2, C1507.2, C1508.2, C1509.2, C1510.2, C1511.2, C1512.2, C1513.2, C1515.2, D1501.5 (VP), FB1501.1, J1.4 (VDD), J1502.1, R1502.2, SW1502.2, U1501.6 (VBAT), U1501.17 (VDD), U1501.30 (VDD), U1501.39 (VDD), U1501.52 (VDD), U1501.62 (VDD), U1501.72 (VDD), U1501.84 (VDD), U1501.95 (VDDUSB), U1501.108 (VDD), U1501.121 (VDDSDMMC), U1501.131 (VDD), U1501.143 (PDR_ON), U1501.144 (VDD)
+5V: U8.1 (IN)
AT1: U1501.44 (PC4)
AT2: U1501.45 (PC5)
AT3: U1501.46 (PB0)
AT4: U1501.47 (PB1)
AUX_SPI_CS: U1501.132 (PG15)
AUX_SPI_MISO: U1501.20 (PF8)
AUX_SPI_MOSI: U1501.21 (PF9)
AUX_SPI_SCK: U1501.19 (PF7)
AV1: U1501.26 (PC0)
AV2: U1501.27 (PC1)
AV3: U1501.28 (PC2)
AV4: U1501.29 (PC3)
AV5: U1501.34 (PA0)
AV6: U1501.35 (PA1)
AV7: U1501.36 (PA2)
AV8: U1501.37 (PA3)
AV9: U1501.40 (PA4)
AV10: U1501.41 (PA5)
AV11: U1501.42 (PA6)
BOOT0: R1513.1, SW1502.1, U1501.138 (BOOT0)
CAN2_RX: U1501.73 (PB12)
CAN2_TX: U1501.74 (PB13)
CAN_RX: U1501.114 (PD0)
CAN_TX: U1501.115 (PD1)
DIGITAL1: U1501.96 (PC6)
DIGITAL2: U1501.64 (PE11)
DIGITAL3: U1501.65 (PE12)
DIGITAL4: U1501.67 (PE14)
DIGITAL5: U1501.66 (PE13)
DIGITAL6: U1501.68 (PE15)
ETB1_DIR: U1501.79 (PD10)
ETB1_DIS: U1501.80 (PD11)
ETB1_PWM: U1501.81 (PD12)
ETB2_DIR: U1501.78 (PD9)
ETB2_DIS: U1501.77 (PD8)
ETB2_PWM: U1501.82 (PD13)
EXP_GPIO0: U1501.56 (PG0)
GND: C1501.2, C1502.2, C1503.1, C1504.1, C1505.1, C1506.1, C1507.1, C1508.1, C1509.1, C1510.1, C1511.1, C1512.1, C1513.1, C1515.1, C1516.2, C1517.1, C1518.2, C1519.2, C1520.2, C1521.2, C1522.2, C1523.2, D1501.2 (VN), J1.6 (VSS), J1.9 (SHIELD), J1501.4, J1502.3, J1502.5, J1502.9, R1501.2, R1504.2, R1511.1, R1513.2, SW1501.2, U8.3 (GND), U1501.16 (VSS), U1501.31 (VSSA), U1501.38 (VSS), U1501.48 (PB2), U1501.51 (VSS), U1501.61 (VSS), U1501.83 (VSS), U1501.94 (VSS), U1501.107 (VSS), U1501.120 (VSS), U1501.130 (VSS), U1502.2 (GND)
HS1: U1501.101 (PA9)
HS2: U1501.100 (PA8)
HS3: U1501.86 (PD15)
HS4: U1501.85 (PD14)
IGN1: U1501.118 (PD4)
IGN2: U1501.117 (PD3)
IGN3: U1501.99 (PC9)
IGN4: U1501.98 (PC8)
IGN5: U1501.97 (PC7)
IGN6: U1501.93 (PG8)
IGN7: U1501.92 (PG7)
IGN8: U1501.91 (PG6)
IGN9: U1501.90 (PG5)
IGN10: U1501.89 (PG4)
IGN11: U1501.88 (PG3)
IGN12: U1501.87 (PG2)
KNOCK_1: U1501.14 (PF4)
KNOCK_2: U1501.15 (PF5)
LED3: D1506.2 (A), U1501.4 (PE5)
LS1: U1501.123 (PD7)
LS2: U1501.124 (PG9)
LS3: U1501.125 (PG10)
LS4: U1501.126 (PG11)
LS5: U1501.127 (PG12)
LS6: U1501.128 (PG13)
LS7: U1501.129 (PG14)
LS8: U1501.134 (PB4)
LS9: U1501.135 (PB5)
LS10: U1501.136 (PB6)
LS11: U1501.137 (PB7)
LS12: U1501.139 (PB8)
LS13: U1501.140 (PB9)
LS14: U1501.141 (PE0)
LS15: U1501.142 (PE1)
LS16: U1501.1 (PE2)
unnamed: C1518.1, U1501.71 (VCAP_1)
unnamed: C1519.1, U1501.106 (VCAP_2)
unnamed: C1520.1, U8.2 (OUT), U1501.32 (VREF+)
unnamed: C1521.1, U1501.23 (PH0), Y1501.1
unnamed: C1522.1, U1501.24 (PH1), Y1501.2
unnamed: D1506.1 (K), R1511.2
unnamed: J1501.1, U1502.5 (VBUS)
PWR_FLAG: C1501.1, C1502.1, FB1501.2, U1501.33 (VDDA)
SD_CS: J1.2 (DAT3/CD), U1501.116 (PD2)
SD_MISO: J1.7 (DAT0), U1501.112 (PC11)
SD_MOSI: J1.3 (CMD), U1501.113 (PC12)
SD_SCK: J1.5 (CLK), U1501.111 (PC10)
SWCLK: J1502.4, U1501.109 (PA14)
SWDIO: J1502.2, U1501.105 (PA13)
UART_RX: U1501.122 (PD6)
UART_TX: U1501.119 (PD5)
USB_D+: J1501.3, U1501.104 (PA12), U1502.1 (I/O1), U1502.6 (I/O1)
USB_D-: J1501.2, U1501.103 (PA11), U1502.3 (I/O2), U1502.4 (I/O2)
USB_SHIELD: C1516.1, J1501.5, R1501.1
VR_1: U1501.58 (PE7)
VR_2: U1501.59 (PE8)
nRESET: C1517.2, J1502.10, R1502.1, SW1501.1, U1501.25 (NRST)

Notes on the sheet:
12V Sense Divider
Red - error
USB
Pin header
Baro pressure sensor
Green - power
Blue - comms
Cortex Debug Header
Orange - warning
Green - running
Tag Connect Debug Header
Connector side
