ferraritobias/proteus/hardware/proteus-br/proteus-br.kicad_sch

## KiCad design hardware/proteus-br/proteus-br.kicad_sch (2026-06-11)

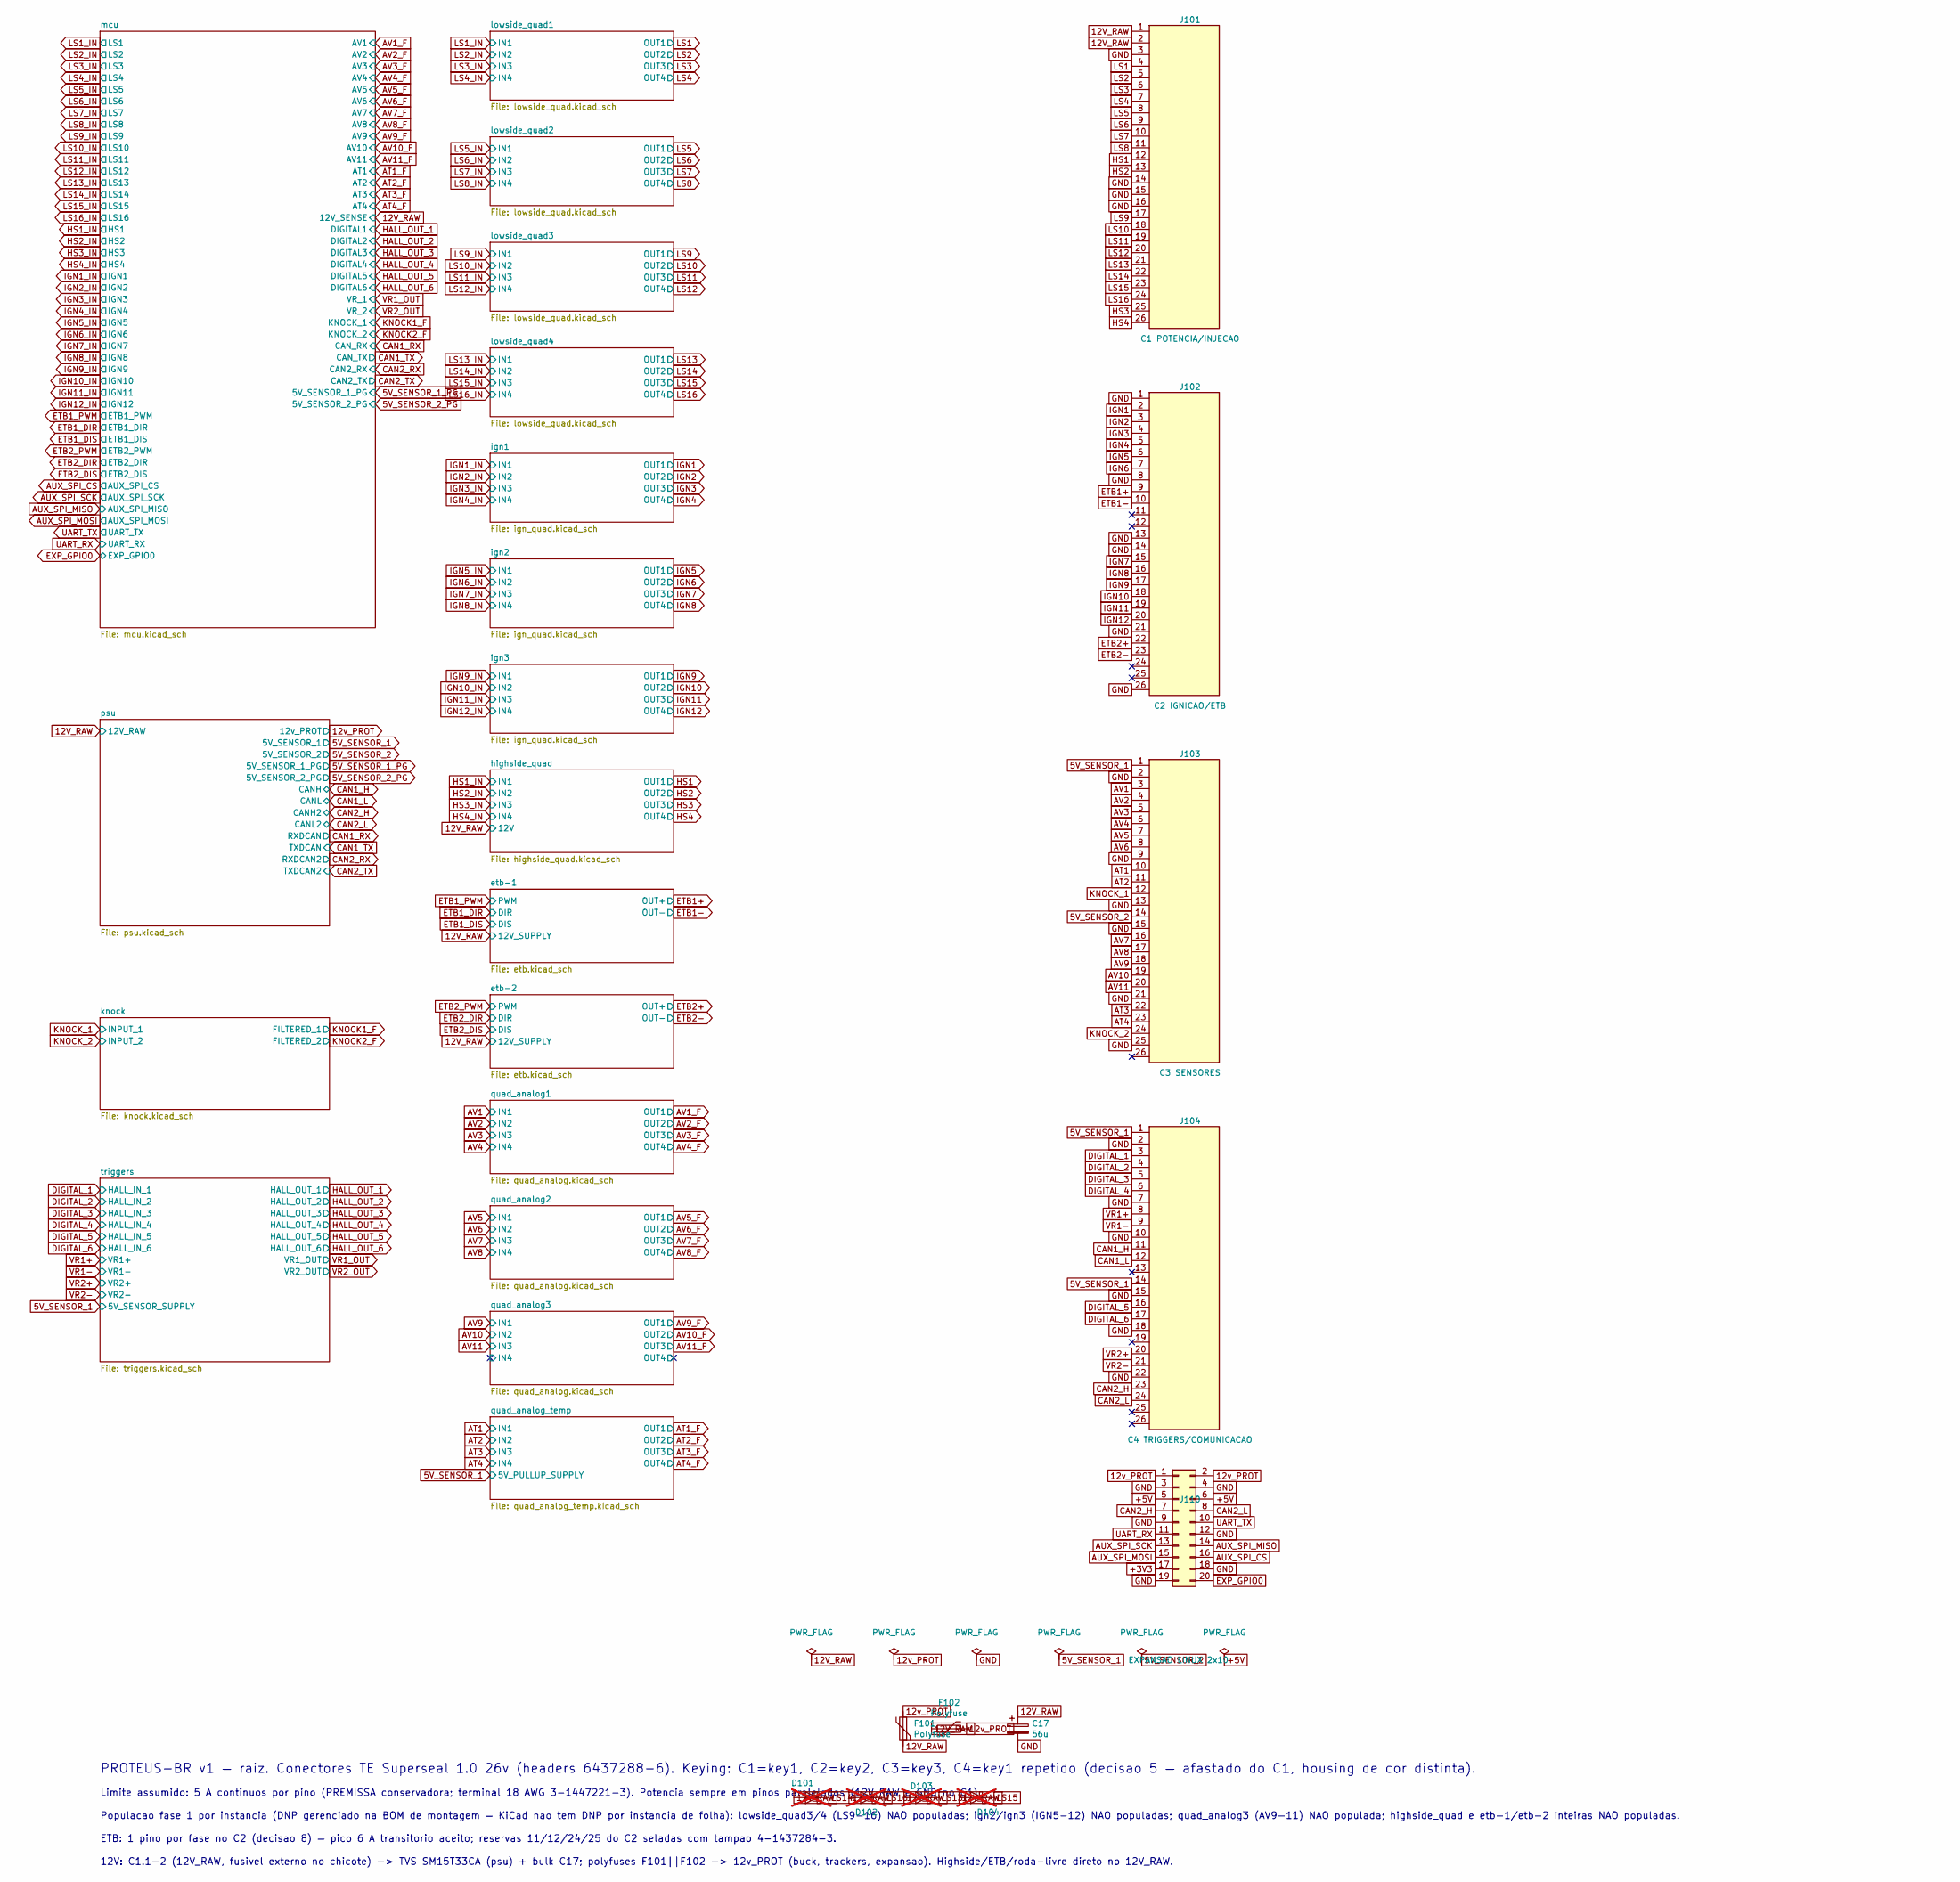
[picture p26: schematic proteus-br.kicad_sch]

Parts:
C17: 56u; CP_Radial_D8.0mm_P3.50mm; LCSC N/A
D101, D102, D103, D104: D_Schottky; D_SMA; LCSC C8678; not fitted
F101, F102: Polyfuse; R_1206_3216Metric; LCSC C207035
J101: C1 POTENCIA/INJECAO; TE_Superseal10_26pos_6437288-6; MPN 6437288-6
J102: C2 IGNICAO/ETB; TE_Superseal10_26pos_6437288-6; MPN 6437288-6
J103: C3 SENSORES; TE_Superseal10_26pos_6437288-6; MPN 6437288-6
J104: C4 TRIGGERS/COMUNICACAO; TE_Superseal10_26pos_6437288-6; MPN 6437288-6
J110: EXPANSAO LINUX 2x10; IDC-Header_2x10_P2.54mm_Vertical; MPN box header IDC 2x10 2.54mm

Connections:
5V_SENSOR_1: J103.1, J104.1, J104.14
5V_SENSOR_2: J103.14
12V_RAW: C17.1, D101.2 (A), D102.2 (A), D103.2 (A), D104.2 (A), F101.1, F102.1, J101.1, J101.2
12v_PROT: F101.2, F102.2, J110.1, J110.2
+3V3: J110.17
+5V: J110.5, J110.6
AT1: J103.10
AT2: J103.11
AT3: J103.22
AT4: J103.23
AUX_SPI_CS: J110.16
AUX_SPI_MISO: J110.14
AUX_SPI_MOSI: J110.15
AUX_SPI_SCK: J110.13
AV1: J103.3
AV2: J103.4
AV3: J103.5
AV4: J103.6
AV5: J103.7
AV6: J103.8
AV7: J103.16
AV8: J103.17
AV9: J103.18
AV10: J103.19
AV11: J103.20
CAN1_H: J104.11
CAN1_L: J104.12
CAN2_H: J104.23, J110.7
CAN2_L: J104.24, J110.8
DIGITAL_1: J104.3
DIGITAL_2: J104.4
DIGITAL_3: J104.5
DIGITAL_4: J104.6
DIGITAL_5: J104.16
DIGITAL_6: J104.17
ETB1+: J102.9
ETB1-: J102.10
ETB2+: J102.22
ETB2-: J102.23
EXP_GPIO0: J110.20
GND: C17.2, J101.3, J101.14, J101.15, J101.16, J102.1, J102.8, J102.13, J102.14, J102.21, J102.26, J103.2, J103.9, J103.13, J103.15, J103.21, J103.25, J104.2, J104.7, J104.10, J104.15, J104.18, J104.22, J110.3, J110.4, J110.9, J110.12, J110.18, J110.19
HS1: J101.12
HS2: J101.13
HS3: J101.25
HS4: J101.26
IGN1: J102.2
IGN2: J102.3
IGN3: J102.4
IGN4: J102.5
IGN5: J102.6
IGN6: J102.7
IGN7: J102.15
IGN8: J102.16
IGN9: J102.17
IGN10: J102.18
IGN11: J102.19
IGN12: J102.20
KNOCK_1: J103.12
KNOCK_2: J103.24
LS1: J101.4
LS2: J101.5
LS3: J101.6
LS4: J101.7
LS5: J101.8
LS6: J101.9
LS7: J101.10
LS8: J101.11
LS9: J101.17
LS10: J101.18
LS11: J101.19
LS12: J101.20
LS13: D103.1 (K), J101.21
LS14: D101.1 (K), J101.22
LS15: D104.1 (K), J101.23
LS16: D102.1 (K), J101.24
UART_RX: J110.11
UART_TX: J110.10
VR1+: J104.8
VR1-: J104.9
VR2+: J104.20
VR2-: J104.21

Notes on the sheet:
PROTEUS-BR v1 — raiz. Conectores TE Superseal 1.0 26v (headers 6437288-6). Keying: C1=key1, C2=key2, C3=key3, C4=key1 repetido (decisao 5 — afastado do C1, housing de cor distinta).
Limite assumido: 5 A continuos por pino (PREMISSA conservadora; terminal 18 AWG 3-1447221-3). Potencia sempre em pinos paralelados (12V_RAW e GND no C1).
Populacao fase 1 por instancia (DNP gerenciado na BOM de montagem — KiCad nao tem DNP por instancia de folha): lowside_quad3/4 (LS9-16) NAO populadas; ign2/ign3 (IGN5-12) NAO populadas; quad_analog3 (AV9-11) NAO populada; highside_quad e etb-1/etb-2 inteiras NAO populadas.
ETB: 1 pino por fase no C2 (decisao 8) — pico 6 A transitorio aceito; reservas 11/12/24/25 do C2 seladas com tampao 4-1437284-3.
12V: C1.1-2 (12V_RAW, fusivel externo no chicote) -> TVS SM15T33CA (psu) + bulk C17; polyfuses F101||F102 -> 12v_PROT (buck, trackers, expansao). Highside/ETB/roda-livre direto no 12V_RAW.
