ferraritobias/proteus/hardware/proteus-br/psu.kicad_sch

## KiCad design hardware/proteus-br/psu.kicad_sch (2026-06-11)

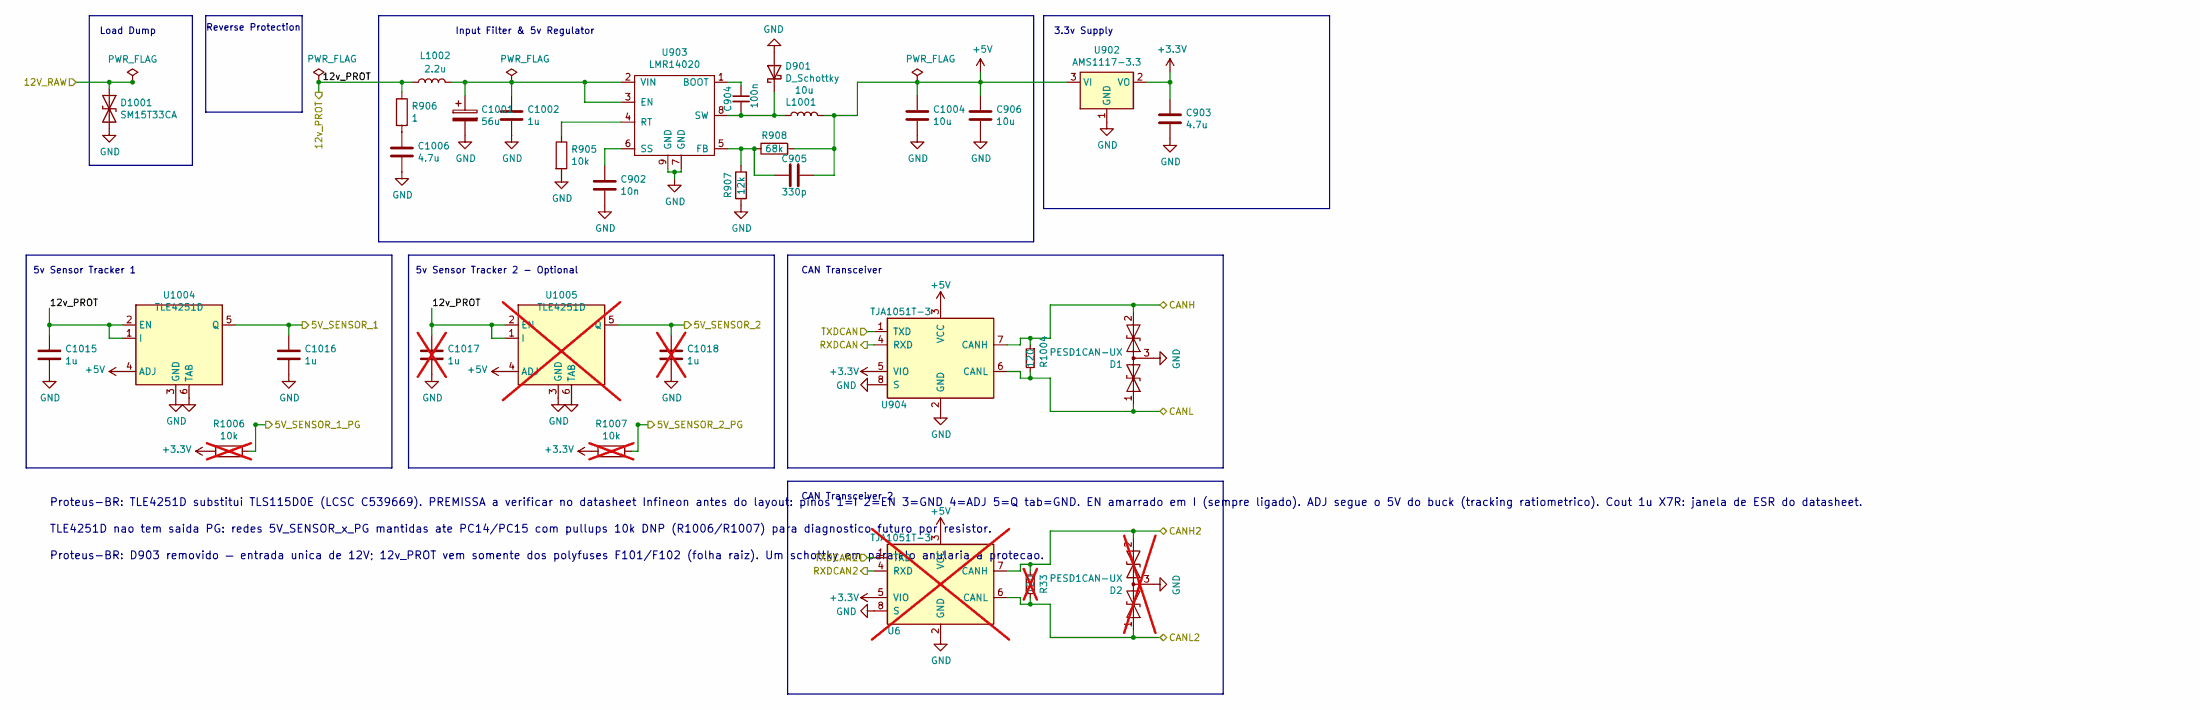
[picture p27: schematic psu.kicad_sch]

Parts:
C902: 10n; C_0603_1608Metric; LCSC C57112
C903, C1006: 4.7u; C_0603_1608Metric; LCSC C19666
C904: 100n; C_0603_1608Metric; LCSC C14663
C905: 330p; C_0603_1608Metric; LCSC C13533
C906, C1004: 10u; C_1206_3216Metric; LCSC C13585
C1001: 56u; CP_Radial_D8.0mm_P3.50mm; LCSC N/A
C1002, C1015, C1016: 1u; C_0603_1608Metric; LCSC C15849
C1017, C1018: 1u; C_0603_1608Metric; LCSC C15849; not fitted
D1: PESD1CAN-UX; SOT-323_SC-70; MPN PESD1CAN,215; LCSC C152727
D2: PESD1CAN-UX; SOT-323_SC-70; MPN PESD1CAN,215; LCSC C152727; not fitted
D901: D_Schottky; D_SMA; LCSC C8678
D1001: SM15T33CA; D_SMC; MPN SM15T33CA; LCSC C133707
L1001: 10u; MWSA0503; LCSC C408412
L1002: 2.2u; L_1210_3225Metric; LCSC C36828
R33: 120; R_0603_1608Metric; LCSC C22787; not fitted
R905: 10k; R_0603_1608Metric; LCSC C25744
R906: 1; R_0603_1608Metric; LCSC C25086
R907: 12k; R_0603_1608Metric; LCSC C25752
R908: 68k; R_0603_1608Metric; LCSC C36871
R1004: 120; R_0603_1608Metric; LCSC C22787
R1006, R1007: 10k; R_0603_1608Metric; LCSC C25744; not fitted
U6: TJA1051T-3; SOIC-8_3.9x4.9mm_P1.27mm; MPN TJA1051T/3; LCSC C38695; not fitted
U902: AMS1117-3.3; SOT-223-3_TabPin2; MPN AMS1117-3.3; LCSC C6186
U903: LMR14020; SOIC-8-1EP_3.9x4.9mm_P1.27mm_EP2.29x3mm; MPN LMR14020SDDAR; LCSC C187824
U904: TJA1051T-3; SOIC-8_3.9x4.9mm_P1.27mm; MPN TJA1051T/3; LCSC C38695
U1004: TLE4251D; TO-252-5_TabPin6; MPN TLE4251D; LCSC C539669
U1005: TLE4251D; TO-252-5_TabPin6; MPN TLE4251D; LCSC C539669; not fitted

Connections:
5V_SENSOR_1: C1016.1, U1004.5 (Q)
5V_SENSOR_1_PG: R1006.1
5V_SENSOR_2: C1018.1, U1005.5 (Q)
5V_SENSOR_2_PG: R1007.1
12V_RAW: D1001.1 (A1)
12v_PROT: C1015.1, C1017.1, L1002.1, R906.1, U1004.1 (I), U1004.2 (EN), U1005.1 (I), U1005.2 (EN)
+3.3V: C903.1, R1006.2, R1007.2, U6.5 (VIO), U902.2 (VO), U904.5 (VIO)
+5V: C905.1, C906.1, C1004.1, L1001.2, R908.2, U6.3 (VCC), U902.3 (VI), U904.3 (VCC), U1004.4 (ADJ), U1005.4 (ADJ)
CANH: D1.2 (A2), R1004.1, U904.7 (CANH)
CANH2: D2.2 (A2), R33.1, U6.7 (CANH)
CANL: D1.1 (A1), R1004.2, U904.6 (CANL)
CANL2: D2.1 (A1), R33.2, U6.6 (CANL)
GND: C902.2, C903.2, C906.2, C1001.2, C1002.2, C1004.2, C1006.2, C1015.2, C1016.2, C1017.2, C1018.2, D1.3 (common), D2.3 (common), D901.2 (A), D1001.2 (A2), R905.2, R907.2, U6.2 (GND), U6.8 (S), U902.1 (GND), U903.7 (GND), U903.9 (GND), U904.2 (GND), U904.8 (S), U1004.3 (GND), U1004.6 (TAB), U1005.3 (GND), U1005.6 (TAB)
unnamed: C902.1, U903.6 (SS)
unnamed: C904.1, U903.1 (BOOT)
unnamed: C904.2, D901.1 (K), L1001.1, U903.8 (SW)
unnamed: C905.2, R907.1, R908.1, U903.5 (FB)
unnamed: C1001.1, C1002.1, L1002.2, U903.2 (VIN), U903.3 (EN)
unnamed: C1006.1, R906.2
unnamed: R905.1, U903.4 (RT)
RXDCAN: U904.4 (RXD)
RXDCAN2: U6.4 (RXD)
TXDCAN: U904.1 (TXD)
TXDCAN2: U6.1 (TXD)

Notes on the sheet:
3.3v Supply
CAN Transceiver 2
5v Sensor Tracker 2 - Optional
Input Filter & 5v Regulator
CAN Transceiver
Reverse Protection
Load Dump
5v Sensor Tracker 1
Proteus-BR: TLE4251D substitui TLS115D0E (LCSC C539669). PREMISSA a verificar no datasheet Infineon antes do layout: pinos 1=I 2=EN 3=GND 4=ADJ 5=Q tab=GND. EN amarrado em I (sempre ligado). ADJ segue o 5V do buck (tracking ratiometrico). Cout 1u X7R: janela de ESR do datasheet.
TLE4251D nao tem saida PG: redes 5V_SENSOR_x_PG mantidas ate PC14/PC15 com pullups 10k DNP (R1006/R1007) para diagnostico futuro por resistor.
Proteus-BR: D903 removido — entrada unica de 12V; 12v_PROT vem somente dos polyfuses F101/F102 (folha raiz). Um schottky em paralelo anularia a protecao.
