ferraritobias/proteus/hardware/proteus-br/quad_analog.kicad_sch

## KiCad design hardware/proteus-br/quad_analog.kicad_sch (2026-06-11)

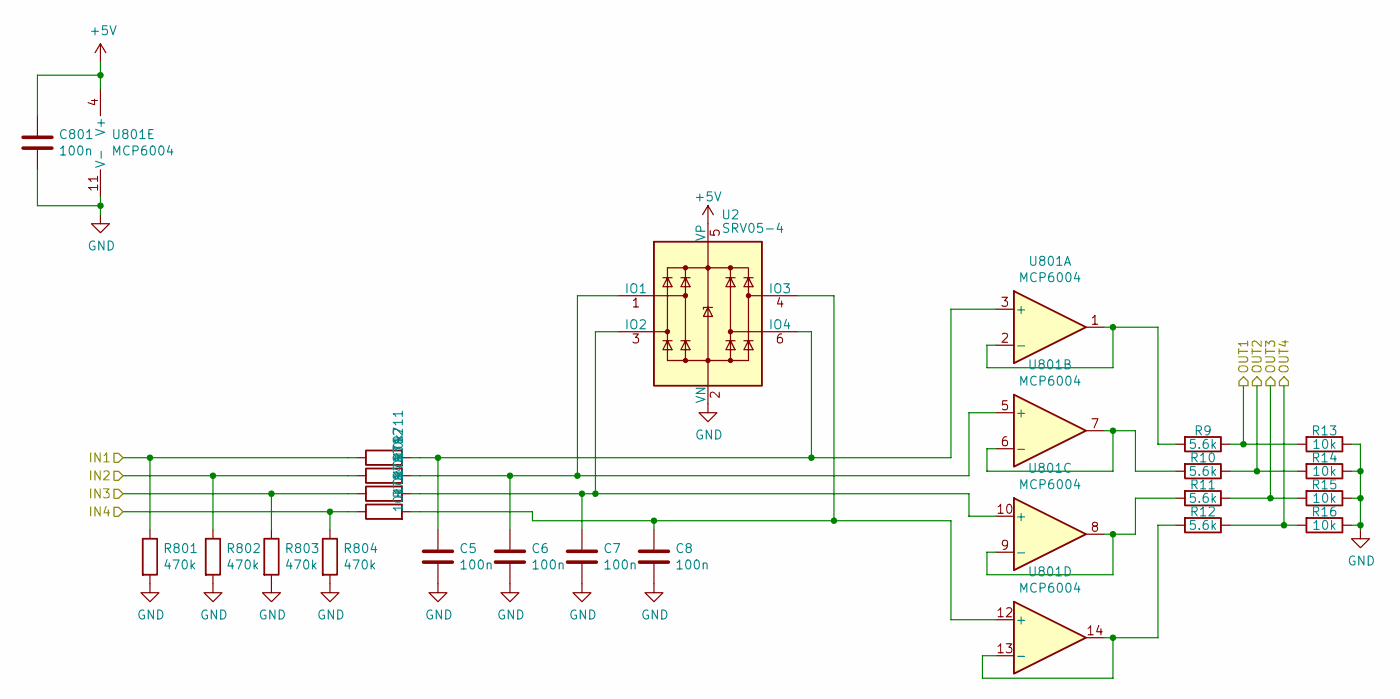
[picture p28: schematic quad_analog.kicad_sch]

Parts:
C5, C6, C7, C8: 100n; C_0603_1608Metric; LCSC C1525
C801: 100n; C_0603_1608Metric; LCSC C14663
R9, R10, R11, R12: 5.6k; R_0603_1608Metric; LCSC C25908
R13, R14, R15, R16: 10k; R_0603_1608Metric; LCSC C25744
R711, R712, R713, R714: 10k; R_0603_1608Metric
R801, R802, R803, R804: 470k; R_0603_1608Metric; LCSC C25790
U2: SRV05-4; SOT-23-6; MPN SRV05-4.TCT; LCSC C13612
U801: MCP6004; TSSOP-14_4.4x5mm_P0.65mm; MPN MCP6004-I/SL; LCSC C7378

Connections:
+5V: C801.1, U2.5 (VP), U801.4 (V+)
GND: C5.2, C6.2, C7.2, C8.2, C801.2, R13.1, R14.1, R15.1, R16.1, R801.2, R802.2, R803.2, R804.2, U2.2 (VN), U801.11 (V-)
IN1: R711.1, R801.1
IN2: R712.1, R802.1
IN3: R713.1, R803.1
IN4: R714.1, R804.1
unnamed: C5.1, R711.2, U2.6 (IO4), U801.3 (+)
unnamed: C6.1, R712.2, U2.1 (IO1), U801.5 (+)
unnamed: C7.1, R713.2, U2.3 (IO2), U801.10 (+)
unnamed: C8.1, R714.2, U2.4 (IO3), U801.12 (+)
unnamed: R9.2, U801.1, U801.2 (-)
unnamed: R10.2, U801.6 (-), U801.7
unnamed: R11.2, U801.8, U801.9 (-)
unnamed: R12.2, U801.13 (-), U801.14
OUT1: R9.1, R13.2
OUT2: R10.1, R14.2
OUT3: R11.1, R15.2
OUT4: R12.1, R16.2
