ferraritobias/proteus/hardware/proteus-br/quad_analog_temp.kicad_sch

## KiCad design hardware/proteus-br/quad_analog_temp.kicad_sch (2026-06-11)

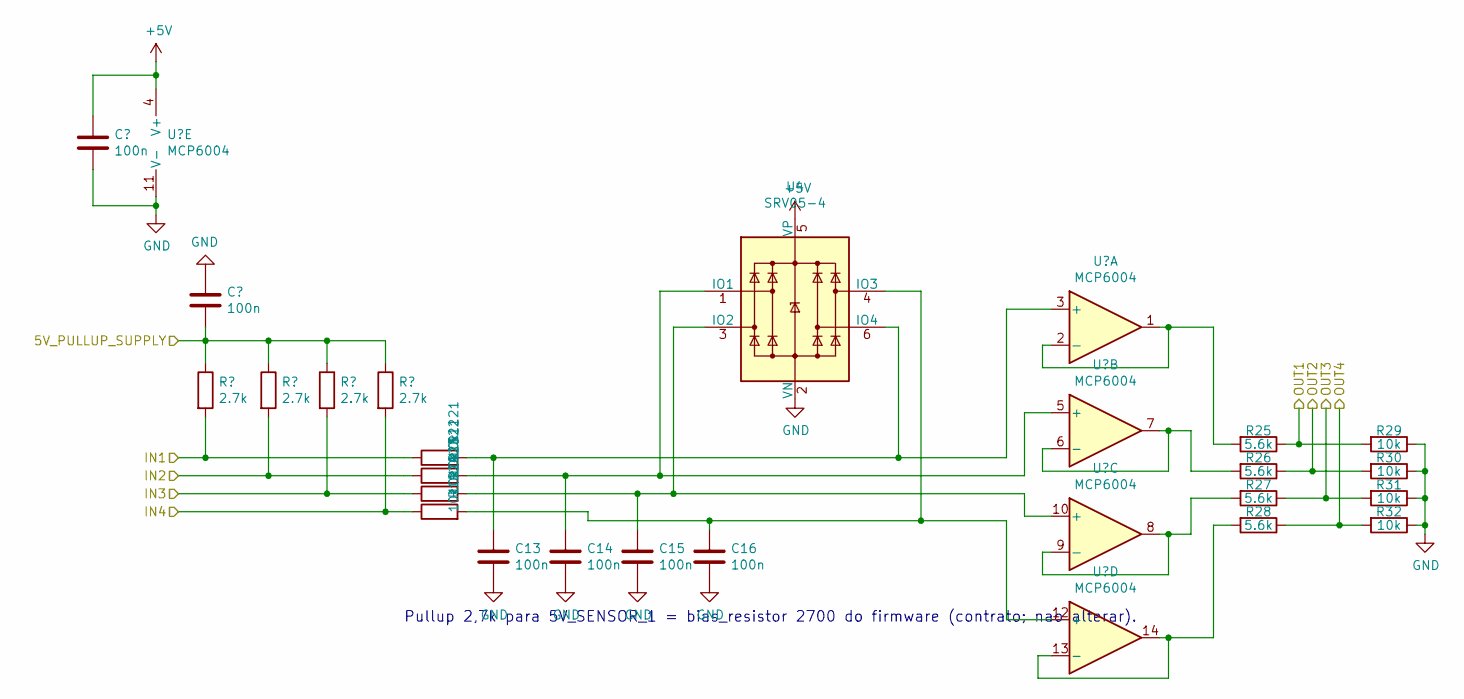
[picture p29: schematic quad_analog_temp.kicad_sch]

Parts:
C13, C14, C15, C16: 100n; C_0603_1608Metric; LCSC C1525
C1101, C1409: 100n; C_0603_1608Metric; LCSC C14663
R25, R26, R27, R28: 5.6k; R_0603_1608Metric; LCSC C25908
R29, R30, R31, R32: 10k; R_0603_1608Metric; LCSC C25744
R1101, R1102, R1103, R1104: 2.7k; R_0603_1608Metric; LCSC C13167
R1121, R1122, R1123, R1124: 10k; R_0603_1608Metric
U4: SRV05-4; SOT-23-6; MPN SRV05-4.TCT; LCSC C13612
U1101: MCP6004; TSSOP-14_4.4x5mm_P0.65mm; MPN MCP6004-I/SL; LCSC C7378

Connections:
5V_PULLUP_SUPPLY: C1409.2, R1101.1, R1102.1, R1103.1, R1104.1
+5V: C1101.1, U4.5 (VP), U1101.4 (V+)
GND: C13.2, C14.2, C15.2, C16.2, C1101.2, C1409.1, R29.1, R30.1, R31.1, R32.1, U4.2 (VN), U1101.11 (V-)
IN1: R1101.2, R1121.1
IN2: R1102.2, R1122.1
IN3: R1103.2, R1123.1
IN4: R1104.2, R1124.1
unnamed: C13.1, R1121.2, U4.6 (IO4), U1101.3 (+)
unnamed: C14.1, R1122.2, U4.1 (IO1), U1101.5 (+)
unnamed: C15.1, R1123.2, U4.3 (IO2), U1101.10 (+)
unnamed: C16.1, R1124.2, U4.4 (IO3), U1101.12 (+)
unnamed: R25.2, U1101.1, U1101.2 (-)
unnamed: R26.2, U1101.6 (-), U1101.7
unnamed: R27.2, U1101.8, U1101.9 (-)
unnamed: R28.2, U1101.13 (-), U1101.14
OUT1: R25.1, R29.2
OUT2: R26.1, R30.2
OUT3: R27.1, R31.2
OUT4: R28.1, R32.2

Notes on the sheet:
Pullup 2,7k para 5V_SENSOR_1 = bias_resistor 2700 do firmware (contrato; nao alterar).
