ferraritobias/proteus/(commit log)

2026-06-09 Add Stage-0 BOMs: 4-cyl, dual CAN, all-SMD on JLC + DNP expansion
    Generate populate sets for the first run (4-cylinder, dual ETB, two CAN
    networks). All SMD assembled by JLC PCBA (including LQFP-144, LGA baro,
    thermal-pad TLE9201 and automotive smart drivers); only TH/mechanical
    parts (AMPSEAL, USB, audio jack, electrolytic) are hand-soldered.
    Ignition banks 5-12 and low-side 9-16 left as DNP with footprints and
    routing intact for later hand expansion. PCB unchanged.
    [proteus-bom-hand.csv, proteus-bom-jlc-stage0.csv, proteus-dnp-stage0.csv]
2026-06-09 Add matched Stage-0 CPL (1:1 with BOM) and document fab package
    Generate proteus-top-pos-stage0.csv trimmed to the 296 assembled
    designators so the JLC upload matches the BOM exactly. README now lists
    the full fab package: unchanged v0.7 gerber + Stage-0 BOM + matched CPL.
    [proteus-top-pos-stage0.csv]
2026-06-10 Proteus-BR: spec freeze (alocação 104 pinos, substituições, BOMs, YAMLs)
    - Copia PINOUT-CONTRACT.md/.csv para docs/proteus-br/
    - SPEC-FREEZE.md: discrepâncias vs original, alocação dos 4 Superseal 26v,
    substituições pesquisadas (lowside, tracker 5V), consolidação de passivos,
    dimensão/zoneamento 170x110 em L, conector de expansão 2x10
    - connectors/*.yaml: 4 arquivos no formato rusEFI para TunerStudio
    - BOM-fase1.csv e BOM-completa.csv com códigos LCSC verificados
    - Resolve item não-resolvido #1 do contrato: 5V_SENSOR_PG vai a PC14/PC15
    https://claude.ai/code/session_01RvbrtRqzdqpMVcxSTtF8Yr
    [BOM-completa.csv, BOM-fase1.csv, PINOUT-CONTRACT.csv]
2026-06-11 proteus-br: ferramental sexp + folha mcu (LED unico PE5, sem RTC/baro, expansao UART/SPI5/PG15/PG0)
    - toolkit de edicao s-expression conectividade-aware (tools/)
    - mcu: remove BT1/D3/D4/D1503, LEDs extras, USB remoto, J2/J1505/J4, LPS25HB
    - AUX_SPI_CS movido PF6->PG15 (decisao 9); PG0 vira EXP_GPIO0
    - UART/AUX_SPI viram labels hierarquicos (conector de expansao)
    - VBAT amarrado ao 3V3; R1513 mantido (pulldown BOOT0, spec citava errado)
    - microSD J1 marcado DNP fase 1
    [mcu.kicad_sch]
2026-06-11 proteus-br: folha psu (TLE4251D, CAN2 DNP, entrada 12V unica)
    - TLS115D0E -> TLE4251D (PG-TO252-5, LCSC C539669); EN auto-alimentado;
    pinout marcado PREMISSA no esquematico (verificar datasheet antes do layout)
    - redes 5V_SENSOR_x_PG mantidas com pullups 10k DNP (sem PG no TLE4251D)
    - CAN2 (U6/D2/R33) DNP fase 1; tracker 2 + caps DNP
    - D903 removido: com polyfuse na raiz, schottky paralelo anularia protecao
    [psu.kicad_sch]
2026-06-11 proteus-br: folha lowside_quad (arrays RN -> 1k discretos 0603)
    [lowside_quad.kicad_sch]
2026-06-11 proteus-br: folhas ign_quad (TC4427A, 100R 0805) e highside_quad (DNP integral)
    [highside_quad.kicad_sch, ign_quad.kicad_sch]
2026-06-11 proteus-br: folhas quad_analog/quad_analog_temp (arrays 10k -> discretos 0603)
    [quad_analog.kicad_sch, quad_analog_temp.kicad_sch]
2026-06-11 proteus-br: folhas triggers (VR/HALL3-6 DNP), knock (sem jack, ch2 DNP) e etb (DNP)
    [etb.kicad_sch, knock.kicad_sch, triggers.kicad_sch]
2026-06-11 proteus-br: title blocks v1 + PWR_FLAG no VDDA (mcu/psu/lowside atualizados)
    [lowside_quad.kicad_sch, mcu.kicad_sch, psu.kicad_sch]
2026-06-11 proteus-br: folha raiz (C1-C4 Superseal 26v, expansao Linux 2x10, polyfuses, roda-livre) + libs locais
    - 104 pinos alocados conforme YAML do spec; reservas com no-connect
    - expansao: 12v_PROT, 5V, 3V3, CAN2, UART (PD5/PD6), SPI5 (PF7-9),
    CS=PG15, reserva=PG0 (decisoes 9/10)
    - TLE4251D e Superseal26 em lib/proteus-br.kicad_sym
    - footprint Superseal 26v marcado DRAFT (drawing TE inacessivel)
    [proteus-br.kicad_sch]
2026-06-11 proteus-br: pipeline de validacao + relatorios + PDF do esquematico
    - validate_contract: 240 checagens netlist x PINOUT-CONTRACT, 0 divergencias
    - erc_lite: 0 problemas, 4 waivers justificados (kicad-cli sch erc
    inexistente no KiCad 7; PPA do KiCad 8 bloqueado no ambiente)
    - BOMs geradas do netlist + diff comentado vs BOM-completa.csv
    [bom-esquematico-completa.csv, bom-esquematico-fase1.csv]
